deanxizian/MicroDuck-Replica/Software/README.md

# 软件

软件部分待补充，包括系统镜像、驱动、舵机标定、IMU 校准，以及相机、ToF 和音频配置。
