deanxizian/MicroDuck-Replica/Hardware/HUB/README.md

# kissqy HUB

采用 kissqy HUB 成品分线板，包含连接器和缓冲电容。供电从 Banana 接入 VIN／GND，舵机总线按实板标记连接。

Blender 使用 HUB V2 参考模型，安装在电池仓支座，两安装孔参考间距为 19 mm。实际版号、连接器及电容高度需与成品核对。

本目录仅提供装配说明，未收录 KiCad 或嘉立创制造文件。采购明细见 [BOM](../../BOM/README.md)。
