deanxizian/MicroDuck-Replica/Hardware/IMU-AMP2.0/README.md

# kissqy IMU AMP2.0

采用外购 IMU TO DXL 成品。此处保留 kissqy 2026-10-15 工程的 KiCad 10.99 导入版及制造参考。

| 资料 | 文件 |
| --- | --- |
| KiCad | [工程](KiCad/IMU-AMP2.0.kicad_pro) · [原理图](KiCad/IMU-AMP2.0.kicad_sch) · [PCB](KiCad/IMU-AMP2.0.kicad_pcb) |
| 嘉立创 | [Gerber](JLC/Gerber-reference.zip) · [原理图 PDF](JLC/schematic.pdf) · [BOM](JLC/BOM-reference.csv) · [坐标](JLC/positions-kicad-reference.csv) |
| 检查记录 | [Verification](Verification/) |

25 个器件、93 个焊盘网络已有导入一致性记录，PCB 附带 11 类元件模型。完整 ERC/DRC 和 SMT 审核未完成，CSV 保留导入图框及安装焊盘记录。

安装孔距 16.51×19.812 mm，使用四个约 2 mm 高隔离垫避开背面焊针；螺钉长度按实装选择。成品固件版本、烧录状态与本机校准需在安装时确认。

遵循 kissqy 个人非商业许可及第三方原许可，见 [来源说明](../../NOTICE.md)。
