deanxizian/MicroDuck-Replica/Hardware/Radxa-ZERO-3W/README.md

# Radxa ZERO 3W

| 方案 | 内存与存储 | 排针 |
| --- | --- | --- |
| 推荐配置 | 2GB RAM、无 eMMC，另配 32GB TF 卡 | 购买已焊排针版 |
| 本机配置 | 4GB RAM＋32GB eMMC，¥800 | 无排针，另购 2×20P 排针焊接 |

主控通过四根柱固定在脸板上，安装柱已下移 1.5 mm，柱高不变。摄像头使用独立安装柱，排线需匹配主控与相机两端的针数、触点面和引脚定义。

本目录仅提供选型与安装说明。采购明细见 [BOM](../../BOM/README.md)。
