deanxizian/MicroDuck-Replica/Peripherals/ToF/README.md

# VL53L5CX 安装

模块横装，焊盘排朝下，光轴朝前；感光中心与摄像头等高。安装孔距 20 mm，23 号打印孔距 19.8 mm；支撑高 3 mm，盲孔底厚 1.3 mm。

采用 SH1.0／4P／10 cm 双头线：一端接 HAT，另一端剪去插头，直接焊到 ToF 模块背面的焊盘。按两端接口定义核对电源、地、SCL 和 SDA，不按线色判断。规格与购买链接见 [BOM](../../BOM/README.md)。

焊好线后再固定模块，整理出线方向后合上头盖。ToF 距离阵列的分区方向需按模块旋转 180° 后的朝向校正；实物走线和测距仍需验证。
