deanxizian/MicroDuck-Replica/Hardware/Banana-NP-F550/JLC/Banana-PPTC-schematic.pdf

1 | 2 | 3 | 4 | 5 | 6
1 | 2 | 3 | 4 | 5 | 6

AB

C

D

AB

C

## D Date: 2026-11-03

Size: A4 | Rev: 0.5-PPTC
KiCad E.D.A. 10.0.7 | Id: 1/1

# Title: MicroDuck Banana - positive-side PPTC prototype

## File: banana_pptc.kicad_sch

## Sheet: /

## Based on jyg9 banana_pcb 0.2; CERN-OHL-P v2

1

1

2

2

J3 POWER_OUT 1

1

J1 BAT+

F1
7A hold / 12V 1

1

J2 BAT-

BATT_POS | VOUT_FUSED

BATT_NEG

F1 reference: Littelfuse 2920L700/12MR, 2920 package.

Ihold 7 A / Itrip 14 A at 20 C; Vmax 12 V. 7 A is NOT an instant cutoff. Check motor startup, warm hold current and fault heating on the actual robot. Board 39.19 x 6.79 x 1.6 mm; 1 oz copper each side. F1 on LEFT; J3 moved 8 mm RIGHT to the revised holder notch. J3.1 LEFT fused positive / J3.2 RIGHT direct battery negative. The PPTC limits current when hot; clear the fault and disconnect power to reset. Not a substitute for battery protection or individual servo protection. 3D fuse is a reference maximum-envelope model; actual substitute and cable fit unverified. Original outline/contact design: jyg9/microduck-community-kit, CERN-OHL-P v2. 2026-11-03: three direct 3 mm front tracks; no back tracks; no vias. MicroDuck NP-F550 Banana PCB + PPTC

0.5-PPTC / positive-side fuse / right wire exit / prototype

### J1 -> F1.1/F1.2 -> J3.1 -> HUB CN1.2 (VIN+) J2 -------------> J3.2 -> HUB CN1.1 (GND-)
