deanxizian/MicroDuck-Replica/Peripherals/Camera/Yahboom-IMX219-parameters.jpg

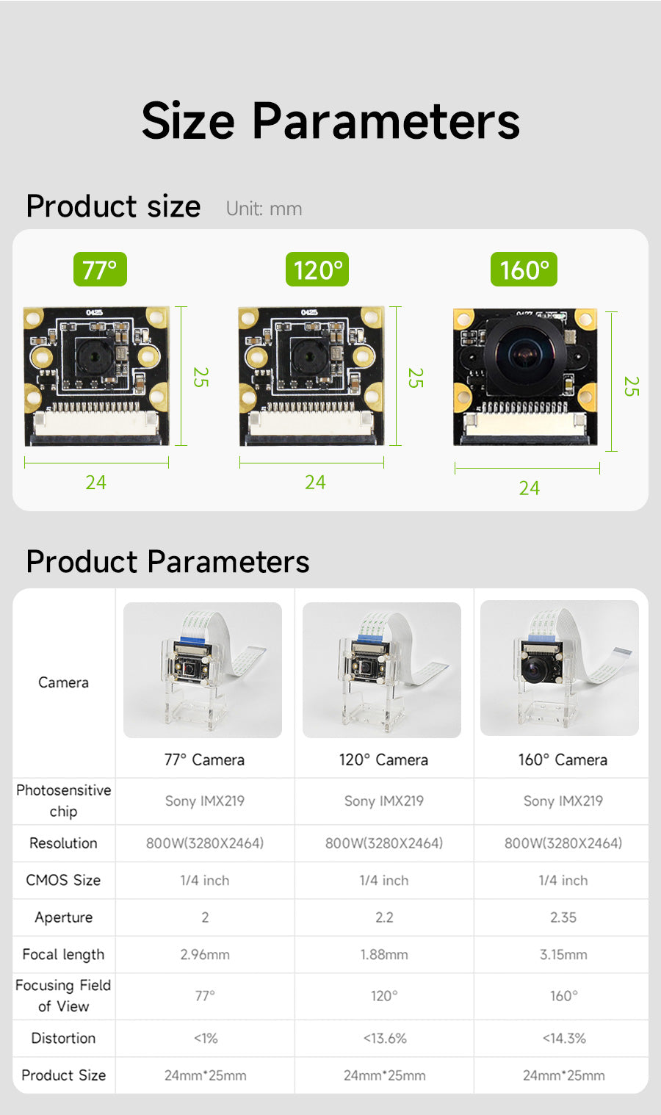
Peripherals/Camera/Yahboom-IMX219-parameters.jpg
