deanxizian/MicroDuck-Replica/Peripherals/Microphone/EM4015-rubber-dimensions.png

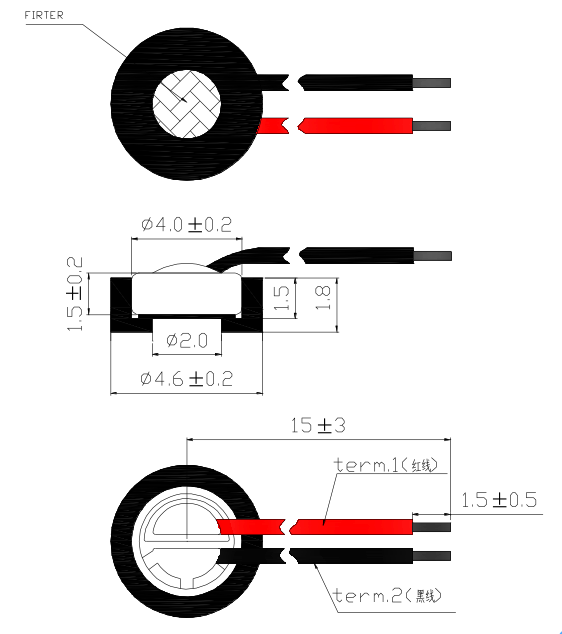
Peripherals/Microphone/EM4015-rubber-dimensions.png
