deanxizian/MicroDuck-Replica/Hardware/Banana-NP-F550/JLC/Banana-PPTC-SMT-BOM.csv

Designator | Quantity | Comment | Footprint | Manufacturer | Manufacturer Part Number | Notes
F1 | 1 | 7A hold / 12V PPTC - prototype selection | PPTC_Littelfuse_2920L | Littelfuse | 2920L700/12MR | User-requested substitute: 伯特 BSMD2920-700-12V; manufacturer datasheet and compatibility unverified.
