deanxizian/MicroDuck-Replica/Hardware/HAT-AMP2.0/JLC/BOM-reference.csv

Refs | Value | Footprint | Qty | DNP
? |  |  | 1
C1 | 1uF / left AC coupling | ProPrj_HAT-easyedapro:C0603 | 1
C2 | 1uF / right AC coupling | ProPrj_HAT-easyedapro:C0603 | 1
C3 | 1uF / VREF | ProPrj_HAT-easyedapro:C0603 | 1
C4 | 1uF | ProPrj_HAT-easyedapro:C0603 | 1
C5 | 10uF | ProPrj_HAT-easyedapro:C0603 | 1
C6 | 1uF | ProPrj_HAT-easyedapro:C0603 | 1
C7 | 10uF | ProPrj_HAT-easyedapro:C0603 | 1
C8 | 220pF | ProPrj_HAT-easyedapro:C0603 | 1
C9 | 220pF | ProPrj_HAT-easyedapro:C0603 | 1
C10 | 1uF / onboard MIC coupling | ProPrj_HAT-easyedapro:C0603 | 1
C11 | 100nF / onboard MIC | ProPrj_HAT-easyedapro:C0603 | 1
C12 | 10uF / 1V8 | ProPrj_HAT-easyedapro:C0603 | 1
C13 | 10uF / 3V3 | ProPrj_HAT-easyedapro:C0603 | 1
C14 | 100nF / oscillator | ProPrj_HAT-easyedapro:C0603 | 1
C15 | 10uF | ProPrj_HAT-easyedapro:C1206 | 1
C16 | 100nF / U5 | ProPrj_HAT-easyedapro:C0603 | 1
C17 | 100nF / U6 | ProPrj_HAT-easyedapro:C0603 | 1
C18 | 100nF / U7 | ProPrj_HAT-easyedapro:C0603 | 1
C20 | 100nF 50V / bootstrap | ProPrj_HAT-easyedapro:C0603 | 1
C21 | 22uF 10V X5R | ProPrj_HAT-easyedapro:C0603 | 1
C22 | 22uF 10V X5R | ProPrj_HAT-easyedapro:C0603 | 1
C26 | 100nF / 1V8 | ProPrj_HAT-easyedapro:C0603 | 1
C27 | 1uF | ProPrj_HAT-easyedapro:C0603 | 1
C28 | 100nF | ProPrj_HAT-easyedapro:C0603 | 1
C29 | 1uF | ProPrj_HAT-easyedapro:C0603 | 1
C30 | 100nF | ProPrj_HAT-easyedapro:C0603 | 1
C31 | 1uF | ProPrj_HAT-easyedapro:C0603 | 1
C32 | 100nF | ProPrj_HAT-easyedapro:C0603 | 1
C33 | 1uF | ProPrj_HAT-easyedapro:C0603 | 1
C34 | 10nF | ProPrj_HAT-easyedapro:C0603 | 1
C35 | 1uF | ProPrj_HAT-easyedapro:C0603 | 1
C36 | 100nF | ProPrj_HAT-easyedapro:C0603 | 1
C37 | 10uF / 3V3 | ProPrj_HAT-easyedapro:C0603 | 1
C38 | 100nF / codec reset | ProPrj_HAT-easyedapro:C0603 | 1
C39 | 100nF 50V | ProPrj_HAT-easyedapro:C0603 | 1
C40 | 1uF / MIC R coupling | ProPrj_HAT-easyedapro:C0603 | 1
C41 | 1uF / MIC L coupling | ProPrj_HAT-easyedapro:C0603 | 1
C42 | 1uF / MIC supply | ProPrj_HAT-easyedapro:C0603 | 1
C43 | 1uF / MIC supply | ProPrj_HAT-easyedapro:C0603 | 1
D1 | BAT54SW / diode 1 used | ProPrj_HAT-easyedapro:SOT-323_L2.0-W1.3-P1.30-LS2.1-BR | 1
D4 | 5V1 / bus clamp | ProPrj_HAT-easyedapro:SOD-323_L1.8-W1.3-LS2.5-RD | 1
D5 | GREEN / RX activity | ProPrj_HAT-easyedapro:LED0603-RD | 1
FB1 | 600R@100MHz 1.3A | ProPrj_HAT-easyedapro:L0603 | 1
FB2 | 120R@100MHz 2A | ProPrj_HAT-easyedapro:L0603 | 1
FB3 | 120R@100MHz 2A | ProPrj_HAT-easyedapro:L0603 | 1
J1 | SPK R / A1251 1.25mm 2P | ProPrj_HAT-easyedapro:CONN-TH_2P-P1.25_A1251WV-2P | 1
J2 | MIC L / A1251 1.25mm 2P | ProPrj_HAT-easyedapro:CONN-TH_2P-P1.25_A1251WV-2P | 1
J4 | FH-00339 stock pins / Zero pair-map / bottom | ProPrj_HAT-easyedapro:HDR-SMD_40P-P2.54-V-F-R2-C20-S6.6_FH-00339 | 1
J5 | ToF / Qwiic / pad 0 GND | ProPrj_HAT-easyedapro:CONN-SMD_BM04B-SRSS-TB | 1
J9 | MIC R / A1251 1.25mm 2P | ProPrj_HAT-easyedapro:CONN-TH_2P-P1.25_A1251WV-2P | 1
J13 | DXL / A2007 2.0mm 3P | ProPrj_HAT-easyedapro:CONN-TH_A2007WV-3P | 1
J14 | DXL / A2007 2.0mm 3P | ProPrj_HAT-easyedapro:CONN-TH_A2007WV-3P | 1
L4 | 6.8uH / 3A / Isat 4.3A | ProPrj_HAT-easyedapro:IND-SMD_L6.0-W6.0_SWPA6045S | 1
MK1 | Onboard analog MEMS MIC | ProPrj_HAT-easyedapro:MIC-SMD_4P-L2.8-W1.9-P1.84-TL | 1
Q1 | MMBT3906 / direction | ProPrj_HAT-easyedapro:SOT-23-3_L2.9-W1.4-P1.91-LS2.6-BR | 1
Q2 | SI2312 / ideal diode MOS | ProPrj_HAT-easyedapro:SOT-23_L2.9-W1.3-P1.90-LS2.4-BR | 1
R1 | 10k / INL | ProPrj_HAT-easyedapro:R0603 | 1
R2 | 10k / INR | ProPrj_HAT-easyedapro:R0603 | 1
R3 | 0R / SHDN high | ProPrj_HAT-easyedapro:R0603 | 1
R4 | 0R / MUTE high | ProPrj_HAT-easyedapro:R0603 | 1
R5 | 0R / MODE high | ProPrj_HAT-easyedapro:R0603 | 1
R6 | 10k / codec reset | ProPrj_HAT-easyedapro:R0603 | 1
R7 | 0R / MIC2L to GND | ProPrj_HAT-easyedapro:R0603 | 1
R8 | 100R | ProPrj_HAT-easyedapro:R0603 | 1
R12 | 10k / SDA pull-up | ProPrj_HAT-easyedapro:R0603 | 1
R13 | 10k / SCL pull-up | ProPrj_HAT-easyedapro:R0603 | 1
R22 | 10k / MIC L bias | ProPrj_HAT-easyedapro:R0603 | 1
R23 | 10k / MIC R bias | ProPrj_HAT-easyedapro:R0603 | 1
R26 | 10k / UART TX pull-up | ProPrj_HAT-easyedapro:R0603 | 1
R27 | 10k / direction base | ProPrj_HAT-easyedapro:R0603 | 1
R28 | 20k / direction pull-down | ProPrj_HAT-easyedapro:R0603 | 1
R29 | 10k / RX gate enable | ProPrj_HAT-easyedapro:R0603 | 1
R31 | 10k / RX pull-up | ProPrj_HAT-easyedapro:R0603 | 1
R32 | 10k / data pull-up | ProPrj_HAT-easyedapro:R0603 | 1
R33 | 0Ω | ProPrj_HAT-easyedapro:R0603 | 1
R34 | 1k / LED current | ProPrj_HAT-easyedapro:R0603 | 1
TH1 | 0Ω | ProPrj_HAT-easyedapro:F0603 | 1
U1 | PAM8406D | ProPrj_HAT-easyedapro:SOIC-16_L9.9-W3.9-P1.27-LS6.0-BL | 1
U2 | TLV320AIC3104IRHBR | ProPrj_HAT-easyedapro:HVQFN-32_L5.0-W5.0-P0.50-TL-EP | 1
U3 | XC6206P182 / 1V8 | ProPrj_HAT-easyedapro:SOT-23-3_L3.0-W1.7-P0.95-LS2.9-BR | 1
U5 | 74LVC1G08 / RX gate | ProPrj_HAT-easyedapro:SOT-23-5_L3.0-W1.7-P0.95-LS2.8-BR | 1
U6 | SN74LVC1G125DBVR | ProPrj_HAT-easyedapro:SOT-23-5_L2.9-W1.6-P0.95-LS2.8-BL | 1
U7 | SN74LVC1G126 / TX | ProPrj_HAT-easyedapro:SOT-23-5_L3.0-W1.7-P0.95-LS2.8-BR | 1
U9 | AP63205 / 5V buck | ProPrj_HAT-easyedapro:TSOT-23-6_L2.9-W1.6-P0.95-LS2.8-BL | 1
U10 | LM5050-1 | ProPrj_HAT-easyedapro:TSOT-23-6_L2.9-W1.6-P0.95-LS2.8-BL | 1
Y1 | 12MHz | ProPrj_HAT-easyedapro:OSC-SMD_4P-L2.5-W2.0-BL | 1
