deanxizian/MicroDuck-Replica/Hardware/HAT-D1-HD1910/JLC/MicroDuck-HAT-D1-HD1910-BOM.csv

Comment | Designator | Footprint | Quantity | 嘉立创元件编号 | Manufacturer | MPN
1uF | C1,C2,C3,C4,C6,C10,C27,C29,C31,C33,C35,C40,C41,C42,C43 | 0402 | 15 | C52923
10uF | C5,C7,C12,C13,C37 | 0603 | 5 | C1691
220nF | C8,C9 | 0402 | 2 | C71693
100nF | C11,C14,C15,C16,C17,C18,C26,C28,C30,C32,C36,C38 | 0402 | 12 | C307331
10uF 63V | C19 | SMD D6.3xH7.7mm | 1 |  | Kemet | EDK106M100A9HAA
100nF 50V | C20 | 0402 | 1 | C307331 | Eurocircuit | GPC0402104
22uF 6.3V | C21,C22 | 0603 | 2 | C84419 | Murata | GRM188R61A226ME15D
100nF 6.3V | C23,C24,C39 | 0402 | 3 | C1525
10nF | C34,C44 | 0402 | 2 | C15195
10uF 35V | C45 | 0805 | 1 | C33546007
BAT54SW,115 | D1 | SOT-323 | 1 | C78606 | Nexperia | BAT54SW,115
3.3V Zener Diode | D2 | D_SOD-123 | 1 | C19077392
BZX384C5V1-E3-08 5.1V | D4 | D_SOD-323 | 1 | C151348 | Vishay | BZX384C5V1-E3-08
1.3A 600R@100MHz | FB1 | 0402 | 1 | C76884 | Murata | BLM15AG601SN1D
2A - 120R@100MHz | FB2,FB3 | 0402 | 2 | C88970
A1251WV-2P | J1,J2,J9 | TH 1x02 P1.25mm | 3 | C225090 | CJT | A1251WV-2P
Dynamixel-4 | J3,J11 | TH 1x04 P2.50mm | 2 | C160258
Female Header 2x20 SMD | J4 | SMD 2x20 P2.54mm | 1 | C2685112
JST SH | J5,J6,J7,J8 | SMD 1x04 P1.00mm | 4 | C160390
A2007WV-3P | J13,J14 | TH 1x03 P2.00mm | 2 | C225336 | CJT | A2007WV-3P
6.8uH 2A | L4 | L_Bourns_SRN6045TA | 1 | C57254 | Bourns | SRN6045TA-6R8M
LMA2718T421-OA5-2 | MK1 | MIC-SMD_4P-L2.8-W1.9-P1.84-TL | 1 | C7587901 | LinkMems | LMA2718T421-OA5-2
MMBT3906 | Q1 | SOT-23 | 1 | C727128
N-Channel 5A | Q2 | TSOT-23 | 1 | C22469448
10kOhm | R1,R2,R6,R12,R13,R20,R21,R24,R26,R27,R29,R31,R32,R34,R35,R38,R39 | 0402 | 17 | C25744
0Ohm | R3,R4,R5,R7,R9,R14,R15,R18,R19,R25,R30,R40 | 0402 | 12 | C17168
100Ohm | R8 | 0402 | 1 | C2906860
4.7kOhm | R22,R23 | 0402 | 2 | C105871
20kOhm | R28 | 0402 | 1 | C25765
150Ohm | R33 | 0402 | 1 | C2909321
1kOhm | R42 | 0402 | 1 | C105637
100R thermistor | TH1 | 0603 | 1 | C913703 | Murata | PRG18BB101MB1RB
Test point loop D2.50mm drill 1.0mm low profile | TP2,TP3,TP4 | TH TestPoint D2.50mm Drill1.0mm | 3
PAM8406D | U1 | SOIC-16 3.9x9.9mm P1.27mm | 1 | C86270
TLV320AIC3104IRHBR | U2 | VQFN-32-1EP_5x5mm_P0.5mm_EP3.5x3.5mm | 1 | C181753
XC6206P182MR | U3 | SOT-23-3 | 1 | C347373
74LVC1G08 | U5 | SOT-23-5 | 1 | C7666
SN74LVC1G125DBV | U6 | SOT-23-5 | 1 | C23654 |  | SN74LVC1G125DBVT
SN74LVC1G126DBVR | U7 | SOT-23-5 | 1 | C7834 | TI | SN74LVC1G126DBVR
GM3088ENA | U8 | DFN-8-1EP_3x3mm_P0.65mm_EP1.2x2.15mm | 1 | C49423279 | Gatemode | GM3088ENA
AP63205 | U9 | TSOT-23-6 | 1 | C2071056 | Diodes Inc. | AP63205WU
LM5050-1 | U10 | TSOT-23-6 | 1 | C473393
LSM6DSV16XTR | U12 | LGA-14_3x2.5mm_P0.5mm_LayoutBorder3x4y | 1 | C5267406
OT3EL89CJI-111YLC-12M 12MHz | Y1 | Oscillator_SMD_Abracon_ASDMB-4Pin_2.5x2.0mm | 1 | C7425459 | YXC Crystal Oscillators | OT3EL89CJI-111YLC-12M
