deanxizian/MicroDuck-Replica/Hardware/IMU-AMP2.0/JLC/BOM-reference.csv

Refs | Value | Footprint | Qty | DNP
? |  |  | 1
C1 | 4.7uF 25V | ProPrj_imu-easyedapro:C0805 | 1
C2 | 100nF 50V | ProPrj_imu-easyedapro:C0603 | 1
C3 | 4.7uF 25V | ProPrj_imu-easyedapro:C0805 | 1
C4 | 100nF 50V | ProPrj_imu-easyedapro:C0603 | 1
C5 | 100nF / MCU | ProPrj_imu-easyedapro:C0603 | 1
C6 | 1uF / MCU | ProPrj_imu-easyedapro:C0603 | 1
C7 | 100nF / VDD_IO | ProPrj_imu-easyedapro:C0603 | 1
C8 | 100nF / VDD | ProPrj_imu-easyedapro:C0603 | 1
C9 | 1uF / IMU local | ProPrj_imu-easyedapro:C0603 | 1
C10 | 100nF / buffer | ProPrj_imu-easyedapro:C0603 | 1
D1 | PESD5V0S1BA / 5V bidirectional | ProPrj_imu-easyedapro:SOD-323_L1.7-W1.3-LS2.7-BI | 1
D2 | DEBUG LED | ProPrj_imu-easyedapro:LED0603-RD | 1
J1 | DXL BUS / CJT A2007WV-3P / AMP 2.0 | ProPrj_imu-easyedapro:CONN-TH_A2007WV-3P | 1
J2 | SWD 1x5 | ProPrj_imu-easyedapro:HDR-TH_5P-P2.54-V-M | 1
R1 | 0R / DXL_VDD link | ProPrj_imu-easyedapro:R0603 | 1
R2 | 10k / NRST pull-up | ProPrj_imu-easyedapro:R0603 | 1
R3 | 100k / BOOT0 pull-down | ProPrj_imu-easyedapro:R0603 | 1
R4 | 10k / IMU CS pull-up | ProPrj_imu-easyedapro:R0603 | 1
R5 | 10k / TX disable pull-up | ProPrj_imu-easyedapro:R0603 | 1
R6 | 33R / DXL TX series | ProPrj_imu-easyedapro:R0603 | 1
R7 | 1k / debug LED | ProPrj_imu-easyedapro:R0603 | 1
U1 | STM32G031F8P6 | ProPrj_imu-easyedapro:TSSOP-20_L6.5-W4.4-P0.65-LS6.4-BL | 1
U2 | LSM6DSV16XTR | ProPrj_imu-easyedapro:LGA-14_L3.0-W2.5-P0.50-BR | 1
U3 | TLV70433DBVR | ProPrj_imu-easyedapro:SOT-23-5_L3.0-W1.7-P0.95-LS2.8-BR | 1
U4 | SN74LVC2G125DCUR | ProPrj_imu-easyedapro:VSON8_L2.0-W2.3-P0.50-LS3.1-BL | 1
