deanxizian/MicroDuck-Replica/Hardware/Banana-NP-F550/KiCad/models/PPTC_2920L_max_envelope.step

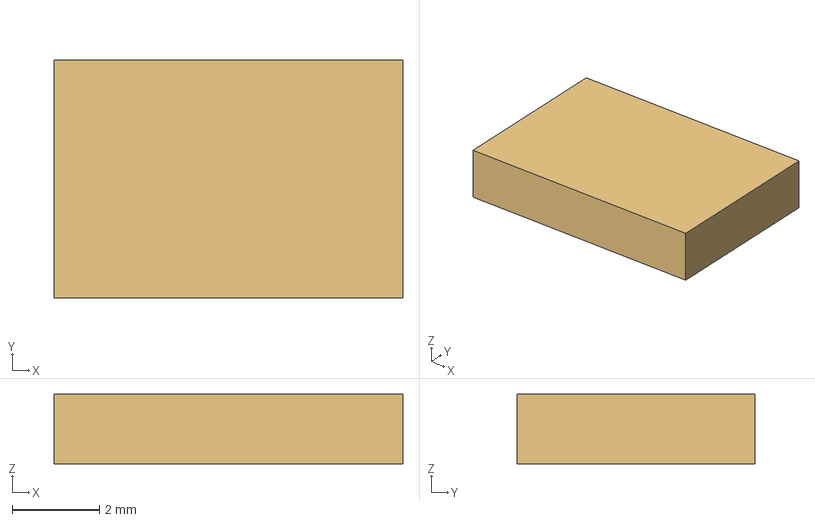
[picture p6: CAD file, 2026-11-04]
Hardware/Banana-NP-F550/KiCad/models/PPTC_2920L_max_envelope.step
7.98 x 5.44 x 1.60 mm
