deanxizian/MicroDuck-Replica/Hardware/HAT-D1-HD1910/KiCad/models/TDFN-8_L3.0-W2.0-H0.8-P0.50.step

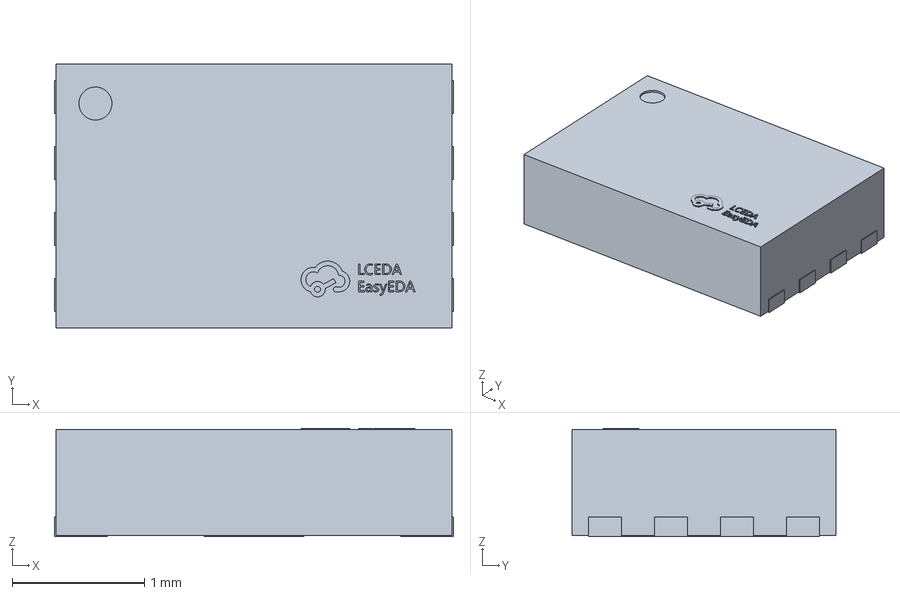
[picture p7: CAD file, 2026-11-04]
Hardware/HAT-D1-HD1910/KiCad/models/TDFN-8_L3.0-W2.0-H0.8-P0.50.step
3.02 x 2.00 x 0.82 mm
