deanxizian/MicroDuck-Replica/Hardware/IMU-AMP2.0/KiCad/models/LED0603-RD.step

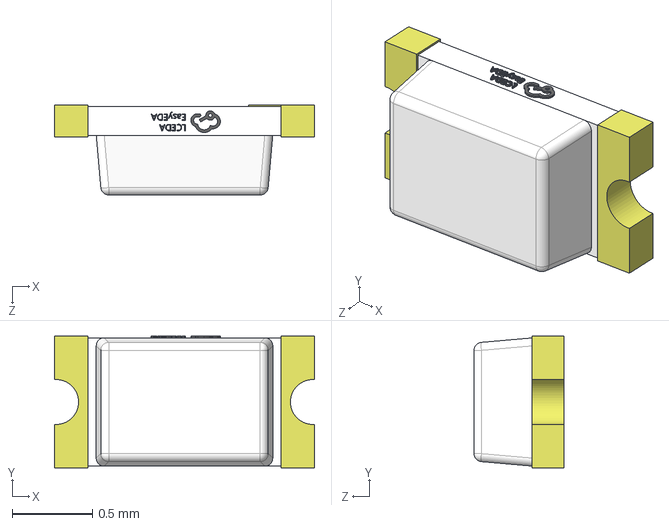
[picture p8: CAD file, 2026-11-04]
Hardware/IMU-AMP2.0/KiCad/models/LED0603-RD.step
1.62 x 0.82 x 0.56 mm
