deanxizian/MicroDuck-Replica/Structure/Print/STEP/01_9000HE_白色_8件/04_右脚掌_9000HE_白色.step

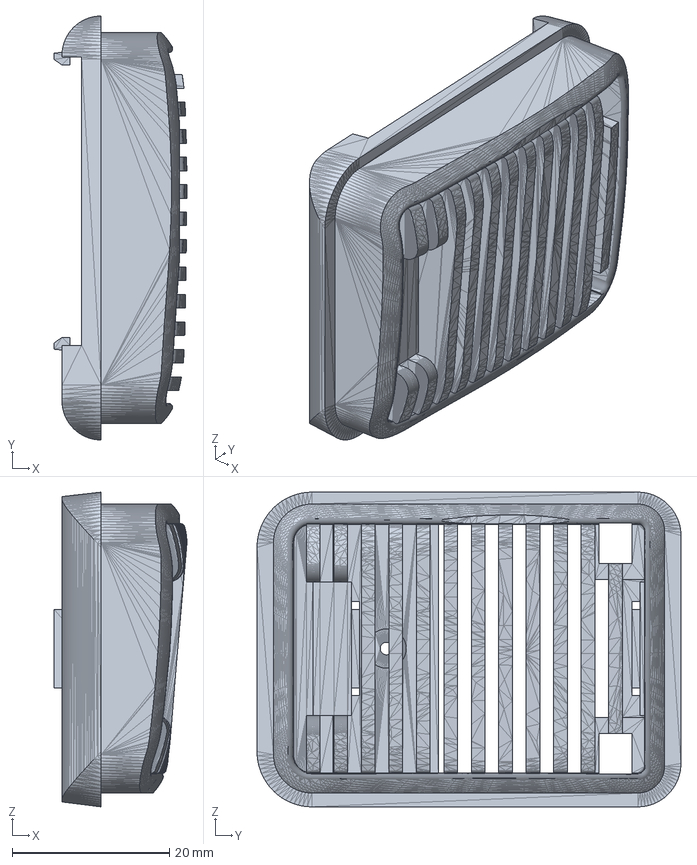
[picture p9: CAD file, 2026-11-04]
Structure/Print/STEP/01_9000HE_白色_8件/04_右脚掌_9000HE_白色.step
16.9 x 54.0 x 40.1 mm
