deanxizian/MicroDuck-Replica/Structure/Print/STEP/02_JLCBlack_黑色_3件/23_脸板_相机柱6.3_ToF横装等高_JLCBlack_黑色.step

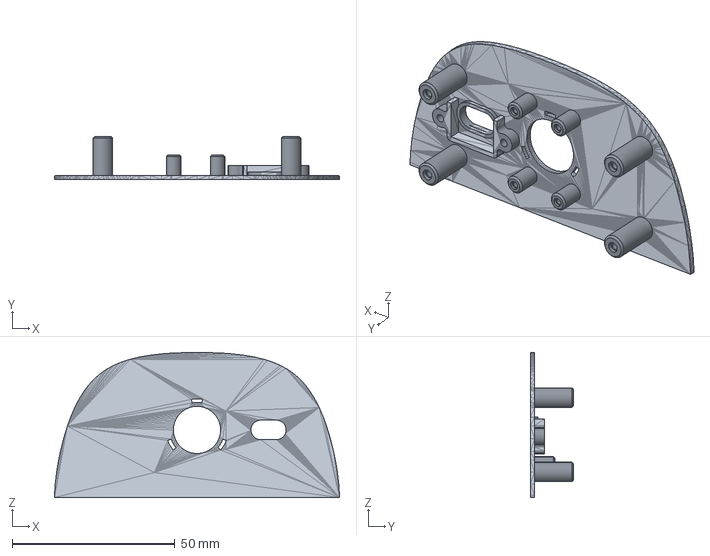
[picture p10: CAD file, 2026-11-05]
Structure/Print/STEP/02_JLCBlack_黑色_3件/23_脸板_相机柱6.3_ToF横装等高_JLCBlack_黑色.step
87.7 x 13.3 x 44.6 mm
