deanxizian/MicroDuck-Replica/Structure/Print/STEP/03_Grey_灰色_16件/16_右胯旋转_Grey_灰色.step

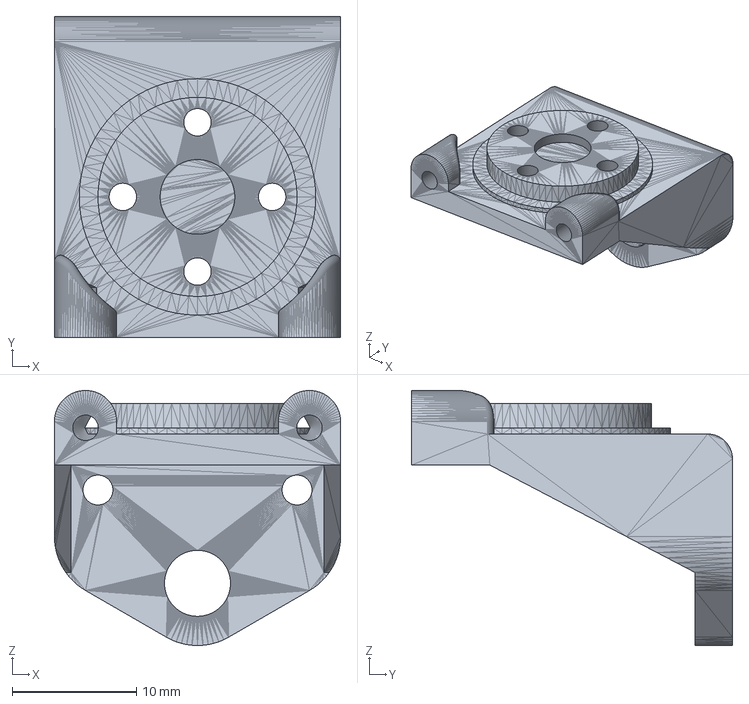
[picture p11: CAD file, 2026-11-04]
Structure/Print/STEP/03_Grey_灰色_16件/16_右胯旋转_Grey_灰色.step
23.0 x 25.8 x 20.5 mm
