deanxizian/MicroDuck-Replica/Structure/Print/STEP/04_TPU95A_黑色_2件/02_右脚底_TPU95A_黑色.step

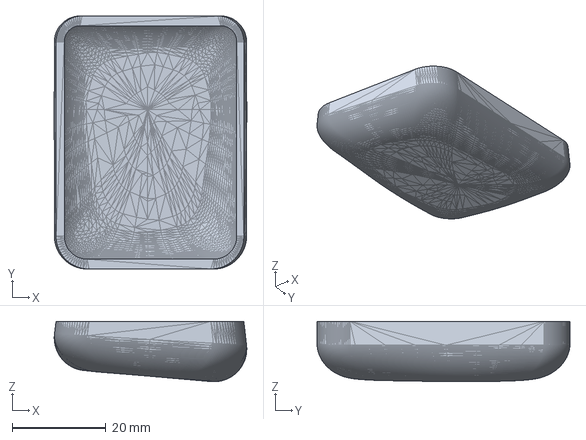
[picture p12: CAD file, 2026-11-04]
Structure/Print/STEP/04_TPU95A_黑色_2件/02_右脚底_TPU95A_黑色.step
41.1 x 54.0 x 12.9 mm
