deanxizian/MicroDuck-Replica/Hardware/Banana-NP-F550/KiCad/models/Banana_U6068_size_reference.step

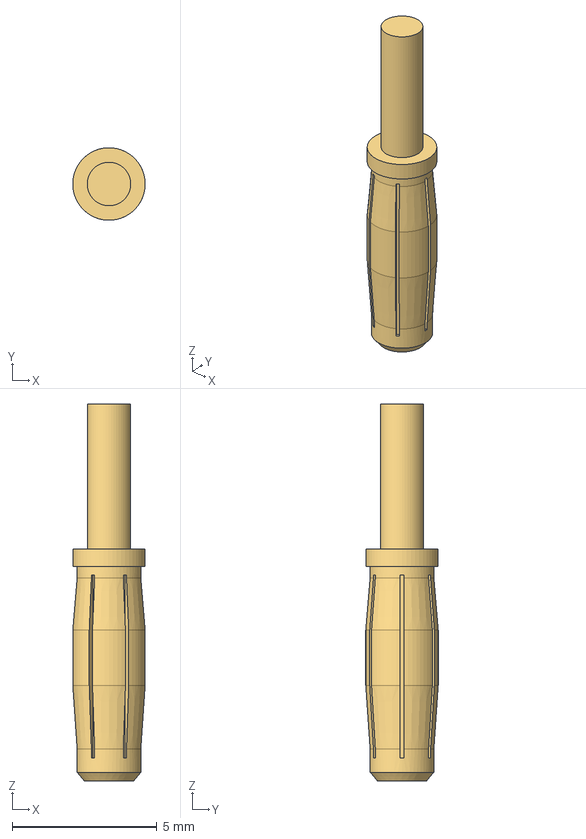
[picture p13: CAD file, 2026-11-04]
Hardware/Banana-NP-F550/KiCad/models/Banana_U6068_size_reference.step
2.50 x 2.50 x 13.0 mm
