deanxizian/MicroDuck-Replica/Hardware/HAT-D1-HD1910/KiCad/models/HDR-SMD_40P-P2.54-V-F-R2-C20-S6.6_FH-00339.step

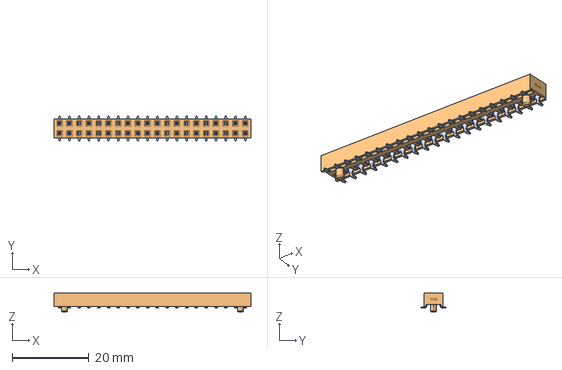
[picture p14: CAD file, 2026-11-04]
Hardware/HAT-D1-HD1910/KiCad/models/HDR-SMD_40P-P2.54-V-F-R2-C20-S6.6_FH-00339.step
51.2 x 6.60 x 4.90 mm
