deanxizian/MicroDuck-Replica/Hardware/IMU-AMP2.0/KiCad/models/C0603_L1.6-W0.8-H0.8.step

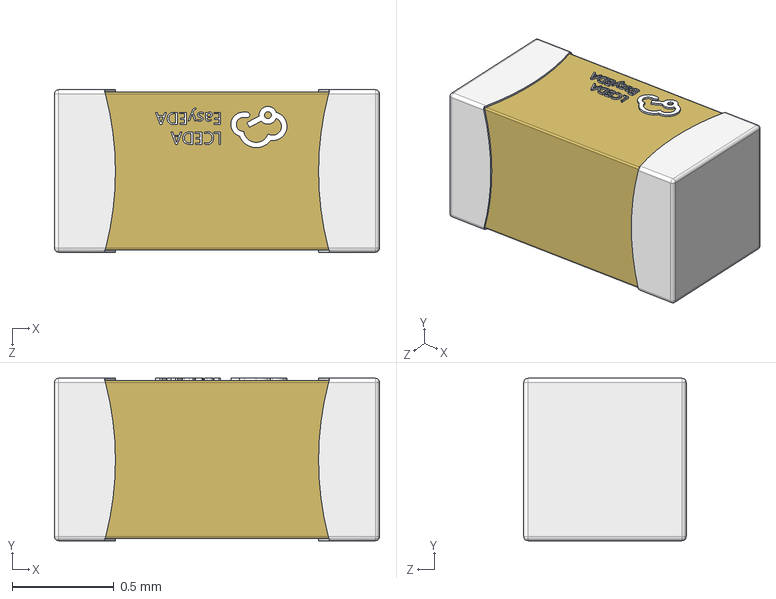
[picture p15: CAD file, 2026-11-04]
Hardware/IMU-AMP2.0/KiCad/models/C0603_L1.6-W0.8-H0.8.step
1.60 x 0.8 x 0.8 mm
