deanxizian/MicroDuck-Replica/Structure/Print/STEP/02_JLCBlack_黑色_3件/27_眼睛_厚6mm_JLCBlack_黑色.step

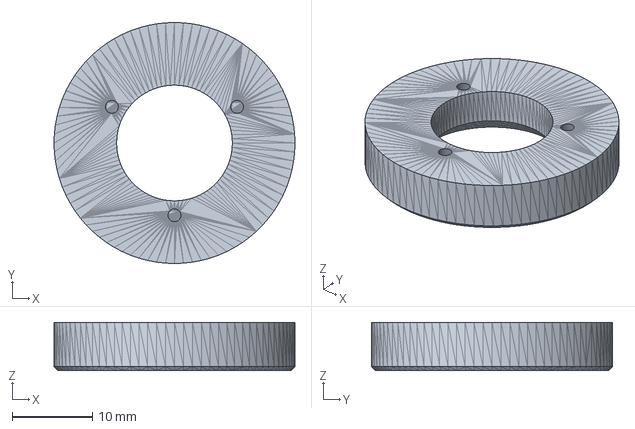
[picture p16: CAD file, 2026-11-05]
Structure/Print/STEP/02_JLCBlack_黑色_3件/27_眼睛_厚6mm_JLCBlack_黑色.step
30.0 x 30.0 x 6.00 mm
