deanxizian/MicroDuck-Replica/Structure/Print/STEP/03_Grey_灰色_16件/19_颈部固定左_Grey_灰色.step

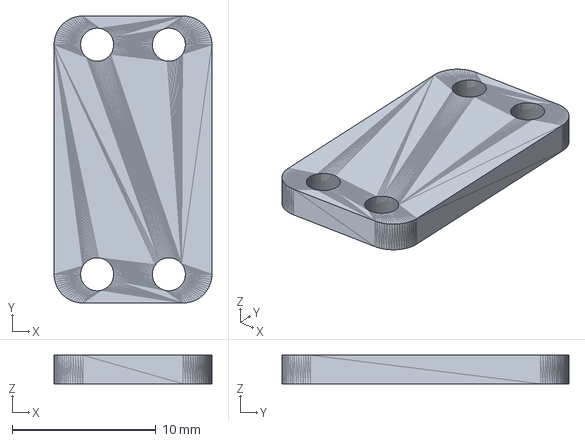
[picture p17: CAD file, 2026-11-04]
Structure/Print/STEP/03_Grey_灰色_16件/19_颈部固定左_Grey_灰色.step
11.0 x 20.0 x 2.00 mm
