deanxizian/MicroDuck-Replica/Hardware/Banana-NP-F550/KiCad/models/PPTC_2920_reference.step

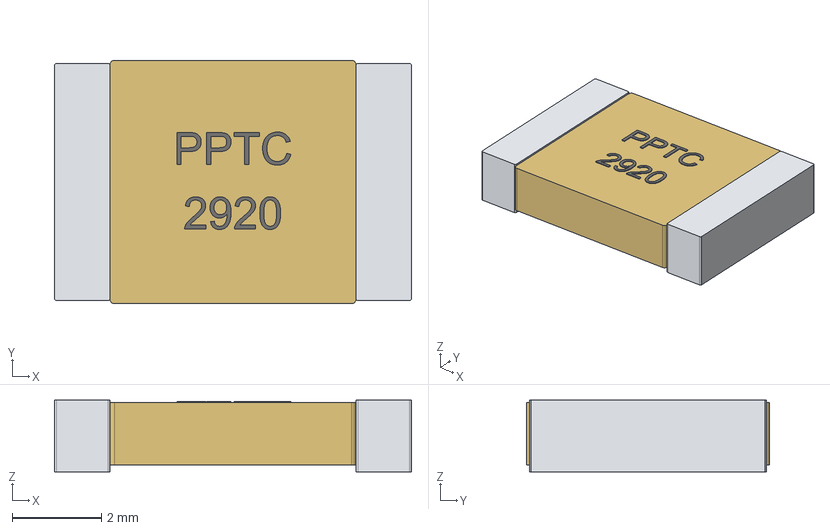
[picture p18: CAD file, 2026-11-04]
Hardware/Banana-NP-F550/KiCad/models/PPTC_2920_reference.step
7.98 x 5.44 x 1.60 mm
PPTC_body_reference
Termination_1
Termination_2
Generic_mark_PPTC
Generic_mark_2920
