deanxizian/MicroDuck-Replica/Hardware/HAT-D1-HD1910/KiCad/models/CONN-TH_MX1.25-LI-2P.step

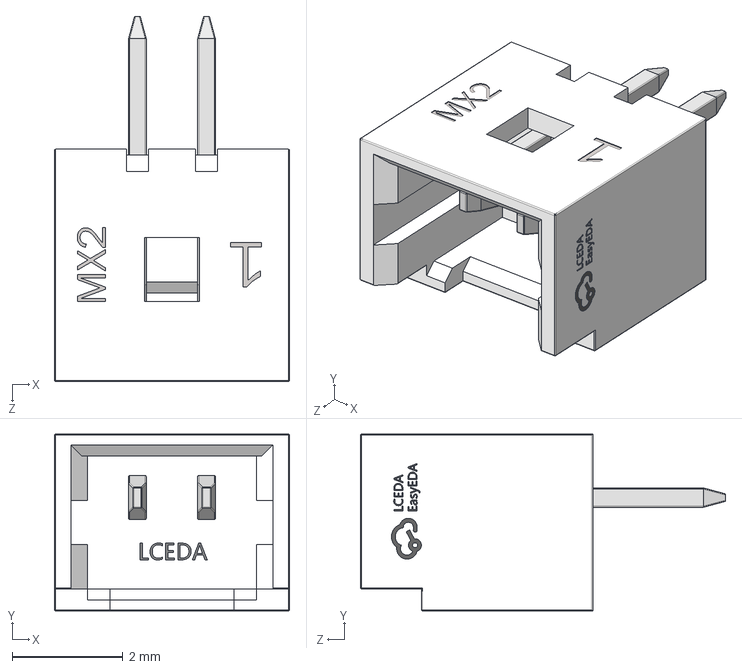
[picture p19: CAD file, 2026-11-04]
Hardware/HAT-D1-HD1910/KiCad/models/CONN-TH_MX1.25-LI-2P.step
4.25 x 3.20 x 6.60 mm
