deanxizian/MicroDuck-Replica/Hardware/IMU-AMP2.0/KiCad/models/R0603.step

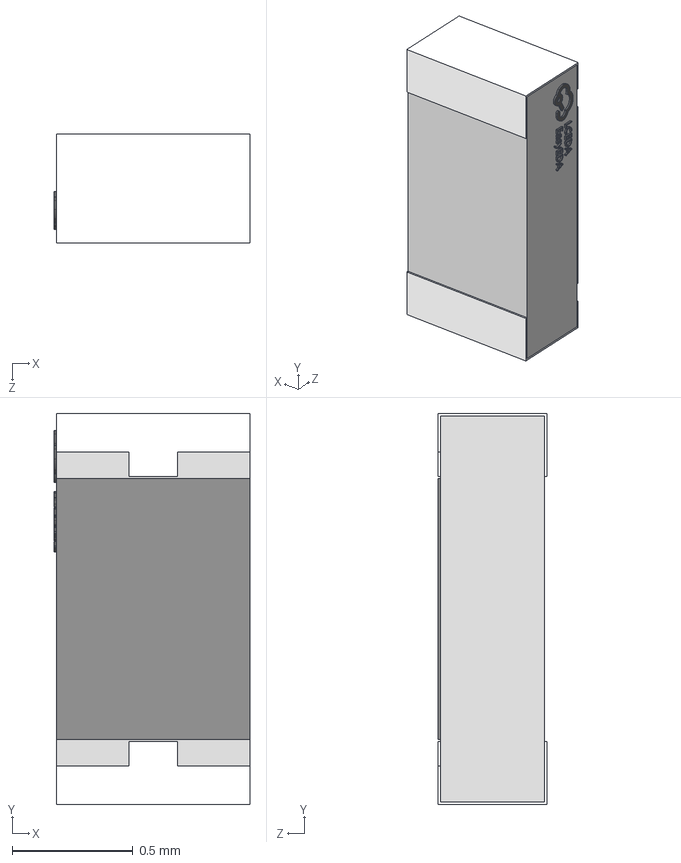
[picture p20: CAD file, 2026-11-04]
Hardware/IMU-AMP2.0/KiCad/models/R0603.step
0.81 x 1.62 x 0.45 mm
