deanxizian/MicroDuck-Replica/Structure/Print/STEP/01_9000HE_白色_8件/25_头盖_双麦_短扬声器粘贴面_9000HE_白色_v3.1.step

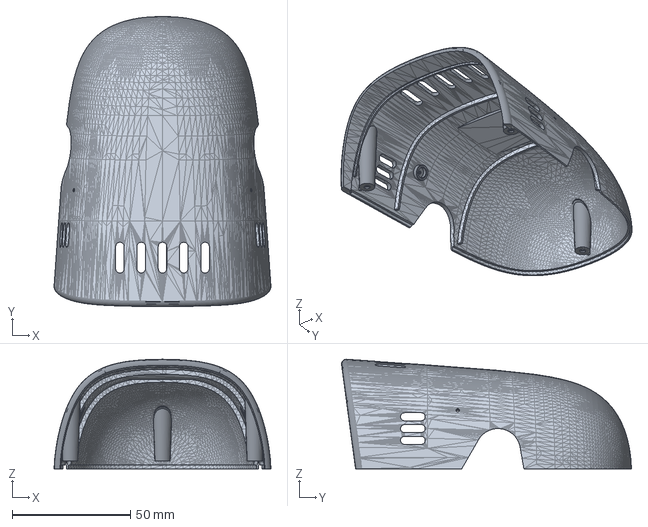
[picture p21: CAD file, 2026-11-04]
Structure/Print/STEP/01_9000HE_白色_8件/25_头盖_双麦_短扬声器粘贴面_9000HE_白色_v3.1.step
91.8 x 122.7 x 46.3 mm
