deanxizian/MicroDuck-Replica/Structure/Print/STEP/02_JLCBlack_黑色_3件/31_电池仓_右侧出线缺口_JLCBlack_黑色_v3.1.step

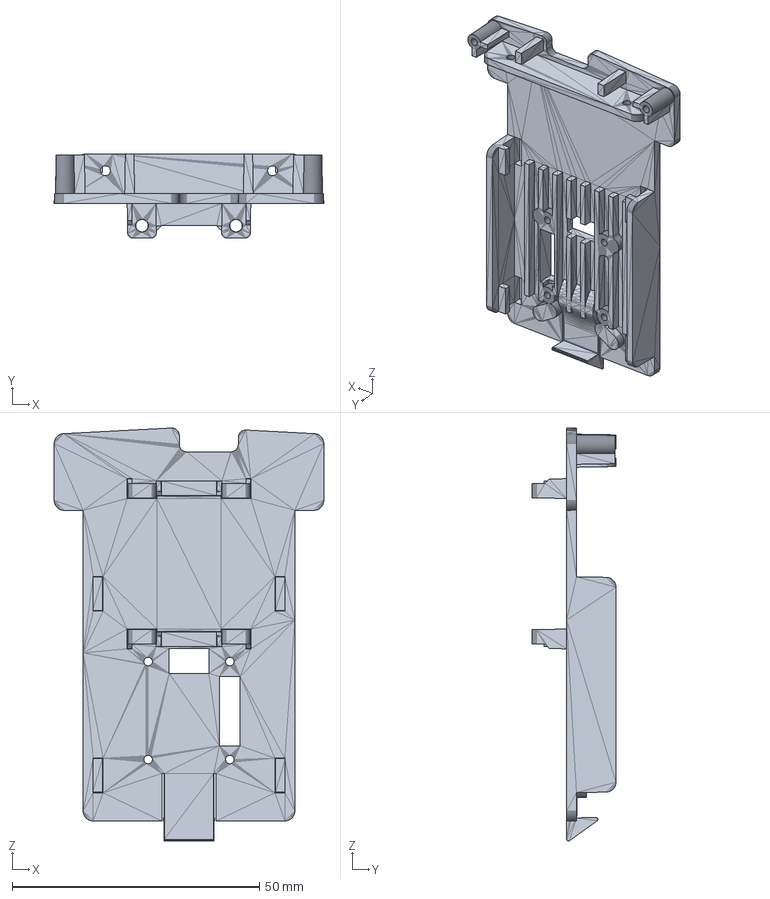
[picture p22: CAD file, 2026-11-04]
Structure/Print/STEP/02_JLCBlack_黑色_3件/31_电池仓_右侧出线缺口_JLCBlack_黑色_v3.1.step
54.5 x 17.0 x 83.5 mm
