deanxizian/MicroDuck-Replica/Hardware/HAT-D1-HD1910/KiCad/models/CONN-TH_A2007WV-3P.step

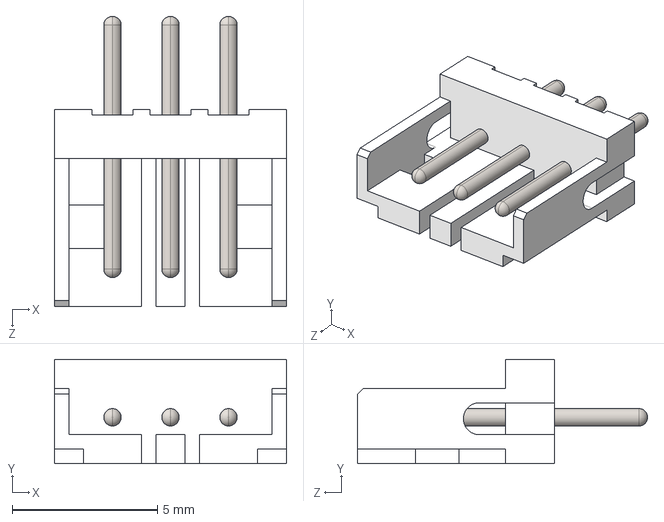
[picture p23: CAD file, 2026-11-04]
Hardware/HAT-D1-HD1910/KiCad/models/CONN-TH_A2007WV-3P.step
8.00 x 3.60 x 10.0 mm
