deanxizian/MicroDuck-Replica/Hardware/IMU-AMP2.0/KiCad/models/C0805_L2.0-W1.3-H1.3.step

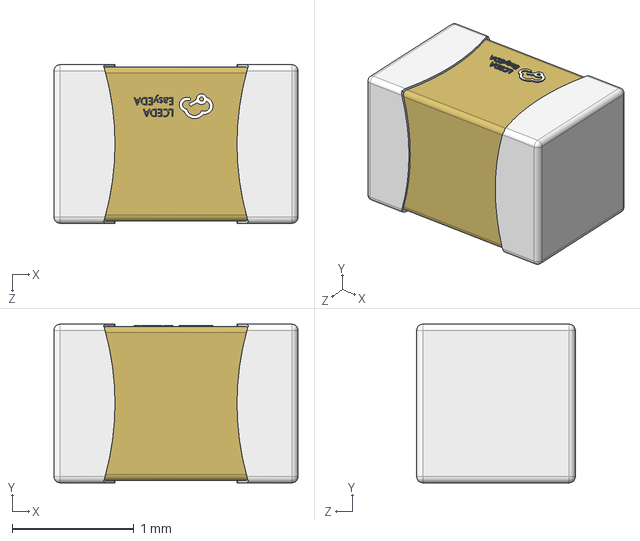
[picture p24: CAD file, 2026-11-04]
Hardware/IMU-AMP2.0/KiCad/models/C0805_L2.0-W1.3-H1.3.step
2.00 x 1.30 x 1.30 mm
