deanxizian/MicroDuck-Replica/Structure/Print/STEP/01_9000HE_白色_8件/29_右壳_连续孔口_9000HE_白色_v3.1.step

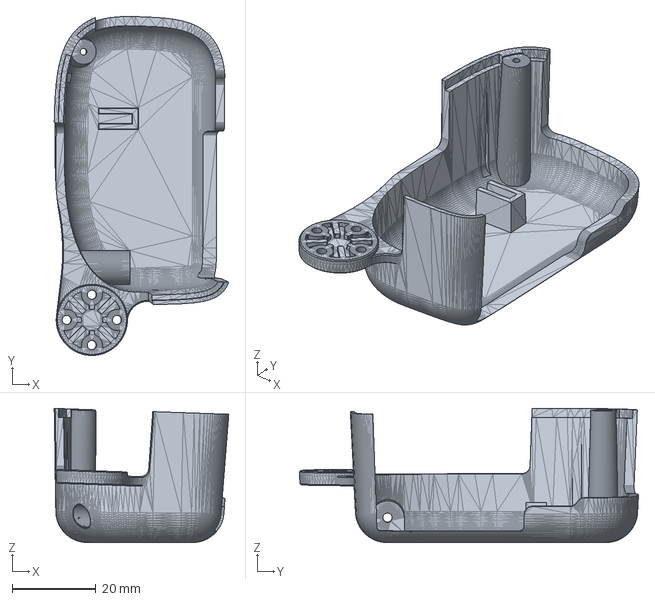
[picture p25: CAD file, 2026-11-04]
Structure/Print/STEP/01_9000HE_白色_8件/29_右壳_连续孔口_9000HE_白色_v3.1.step
41.7 x 80.9 x 32.0 mm
