deanxizian/MicroDuck-Replica/Structure/Print/STEP/03_Grey_灰色_16件/13_左胯侧摆_连续实体_Grey_灰色.step

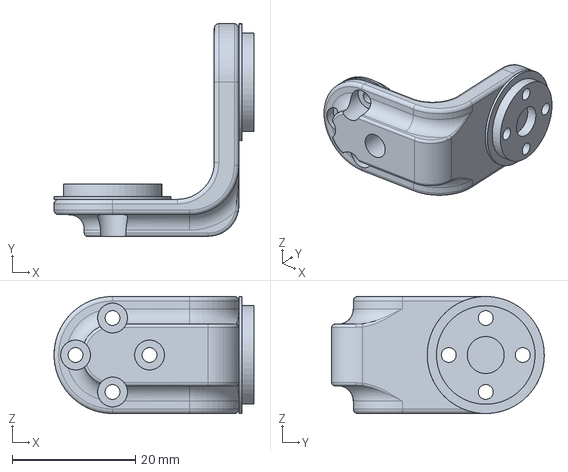
[picture p26: CAD file, 2026-11-04]
Structure/Print/STEP/03_Grey_灰色_16件/13_左胯侧摆_连续实体_Grey_灰色.step
32.5 x 34.5 x 19.0 mm
