deanxizian/MicroDuck-Replica/Hardware/HAT-D1-HD1910/KiCad/models/CONN-TH_DB125-2.54-2P-GN.step

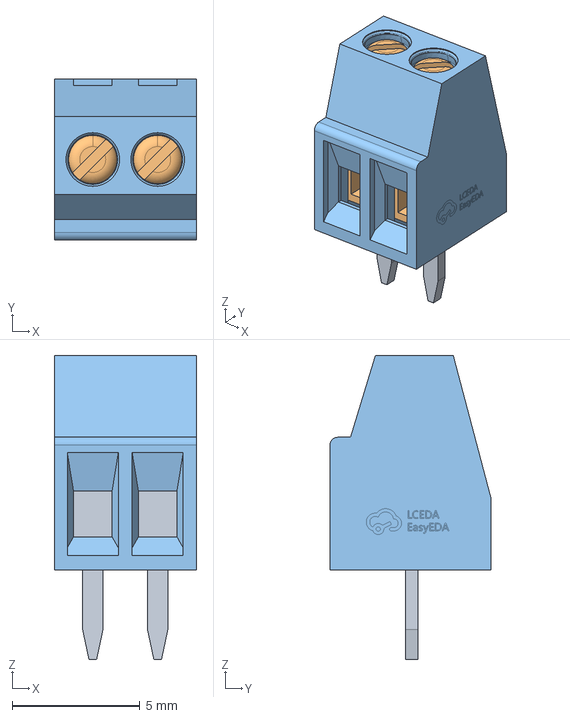
[picture p27: CAD file, 2026-11-04]
Hardware/HAT-D1-HD1910/KiCad/models/CONN-TH_DB125-2.54-2P-GN.step
5.56 x 6.30 x 11.9 mm
