deanxizian/MicroDuck-Replica/Hardware/IMU-AMP2.0/KiCad/models/SOT-23-5_L2.9-W1.6-H1.1-LS2.8-P0.95.step

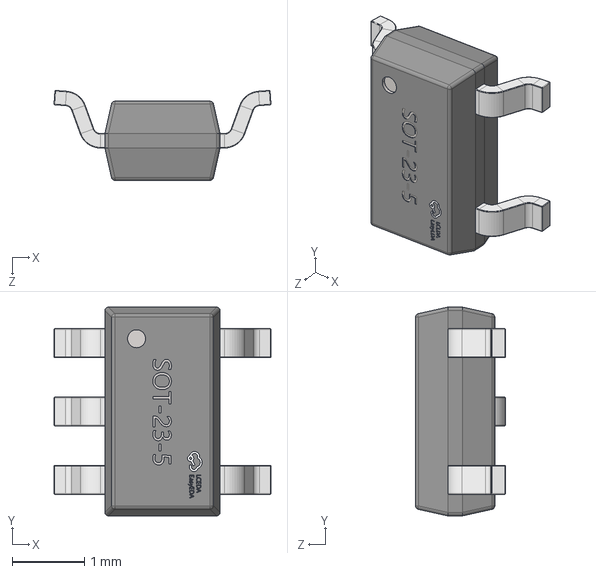
[picture p28: CAD file, 2026-11-04]
Hardware/IMU-AMP2.0/KiCad/models/SOT-23-5_L2.9-W1.6-H1.1-LS2.8-P0.95.step
3.01 x 2.90 x 1.25 mm
