deanxizian/MicroDuck-Replica/Structure/Print/STEP/01_9000HE_白色_8件/09_左胯外盖_深装柱_9000HE_白色_v3.1.step

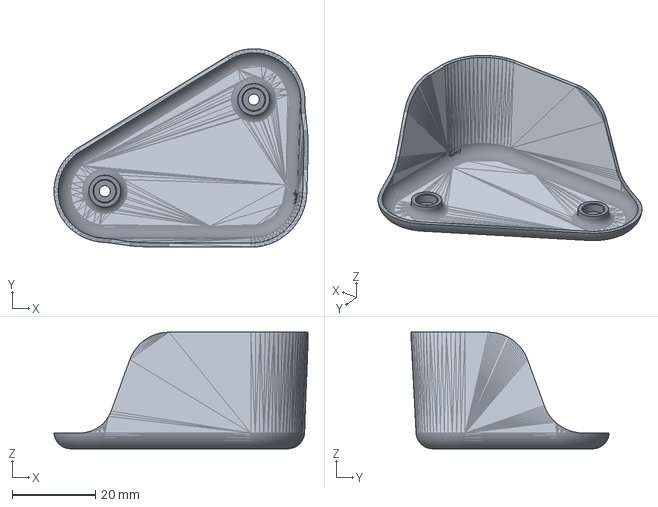
[picture p29: CAD file, 2026-11-04]
Structure/Print/STEP/01_9000HE_白色_8件/09_左胯外盖_深装柱_9000HE_白色_v3.1.step
61.0 x 47.7 x 28.0 mm
