deanxizian/MicroDuck-Replica/Hardware/HAT-D1-HD1910/KiCad/models/MIC-SMD_4P-L2.8-W1.9-H1.0-P1.84-TL.step

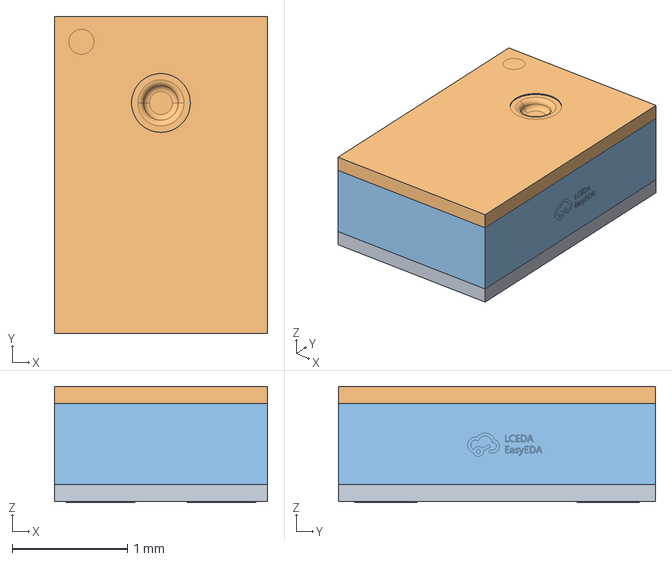
[picture p30: CAD file, 2026-11-04]
Hardware/HAT-D1-HD1910/KiCad/models/MIC-SMD_4P-L2.8-W1.9-H1.0-P1.84-TL.step
1.85 x 2.75 x 1.01 mm
