deanxizian/MicroDuck-Replica/Hardware/IMU-AMP2.0/KiCad/models/LGA-14_L3.0-W2.5-P0.50-BR.step

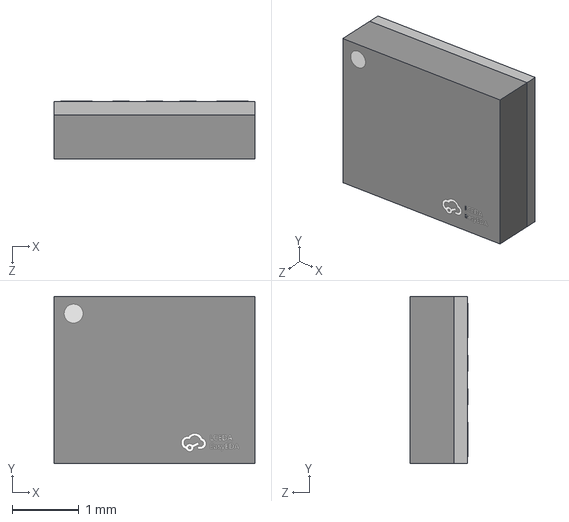
[picture p31: CAD file, 2026-11-04]
Hardware/IMU-AMP2.0/KiCad/models/LGA-14_L3.0-W2.5-P0.50-BR.step
3.00 x 2.50 x 0.871 mm
