deanxizian/MicroDuck-Replica/Structure/Print/STEP/03_Grey_灰色_16件/08_右膝支撑_Grey_灰色.step

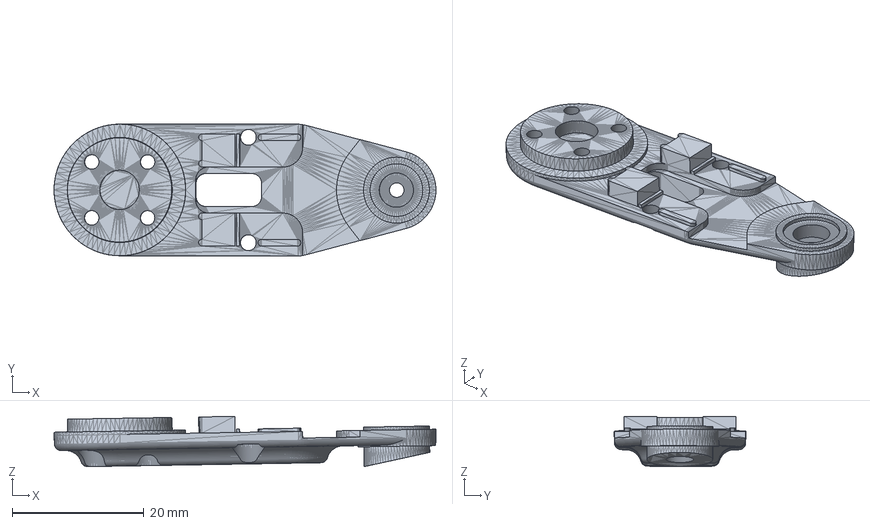
[picture p32: CAD file, 2026-11-04]
Structure/Print/STEP/03_Grey_灰色_16件/08_右膝支撑_Grey_灰色.step
58.0 x 20.0 x 7.63 mm
