deanxizian/MicroDuck-Replica/Hardware/IMU-AMP2.0/KiCad/models/TSSOP-20_L6.5-W4.4-H1.0-LS6.4-P0.65.step

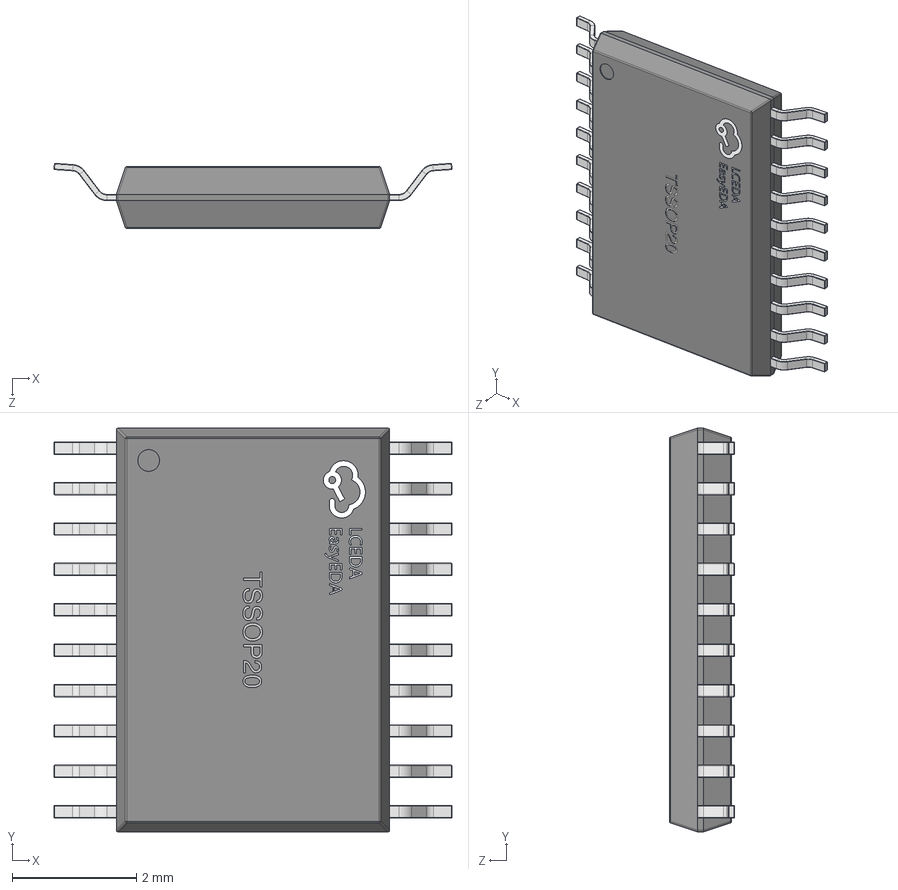
[picture p33: CAD file, 2026-11-04]
Hardware/IMU-AMP2.0/KiCad/models/TSSOP-20_L6.5-W4.4-H1.0-LS6.4-P0.65.step
6.41 x 6.50 x 1.05 mm
