deanxizian/MicroDuck-Replica/Structure/Print/STEP/01_9000HE_白色_8件/32_头部集成盖_兼容hat插口_9000HE_白色.step

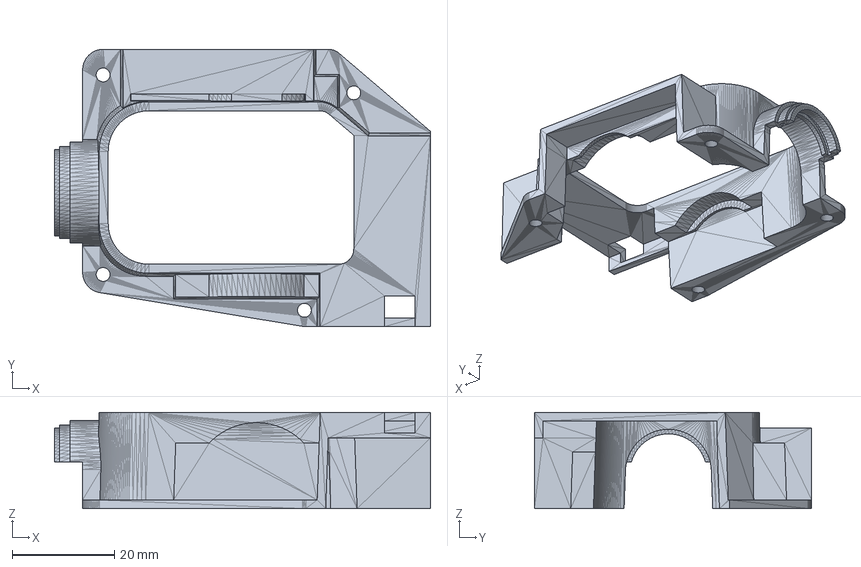
[picture p34: CAD file, 2026-11-04]
Structure/Print/STEP/01_9000HE_白色_8件/32_头部集成盖_兼容hat插口_9000HE_白色.step
73.5 x 54.2 x 18.8 mm
