deanxizian/MicroDuck-Replica/Structure/Print/STEP/03_Grey_灰色_16件/17_左胯固定片_Grey_灰色.step

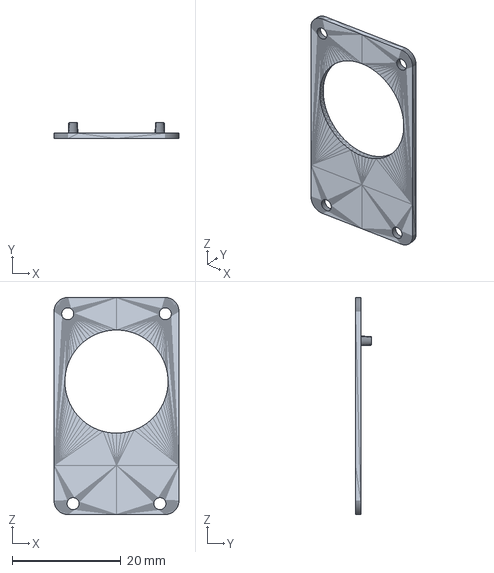
[picture p35: CAD file, 2026-11-04]
Structure/Print/STEP/03_Grey_灰色_16件/17_左胯固定片_Grey_灰色.step
23.0 x 3.00 x 40.0 mm
