deanxizian/MicroDuck-Replica/Hardware/IMU-AMP2.0/KiCad/models/US-8_L2.0-W2.3-H0.9-LS3.1-P0.50.step

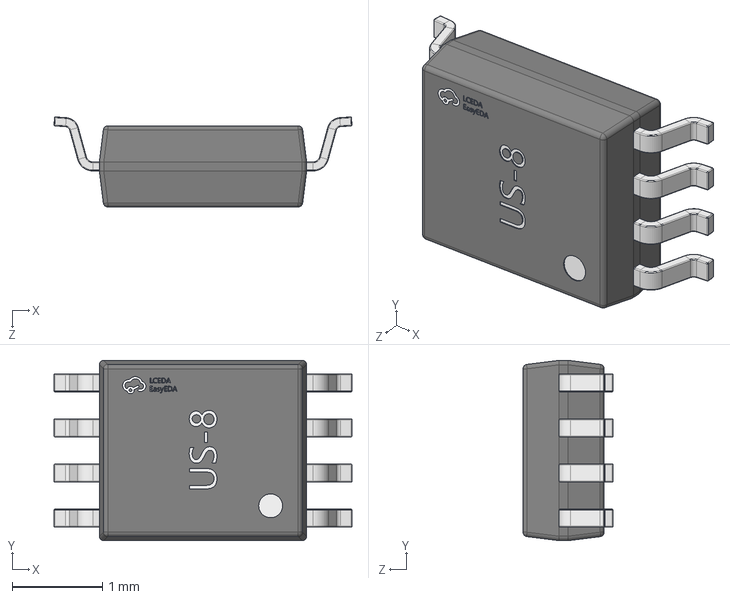
[picture p36: CAD file, 2026-11-04]
Hardware/IMU-AMP2.0/KiCad/models/US-8_L2.0-W2.3-H0.9-LS3.1-P0.50.step
3.31 x 2.00 x 1.00 mm
