deanxizian/MicroDuck-Replica/Structure/Print/STEP/01_9000HE_白色_8件/28_左壳_连续孔口_9000HE_白色_v3.1.step

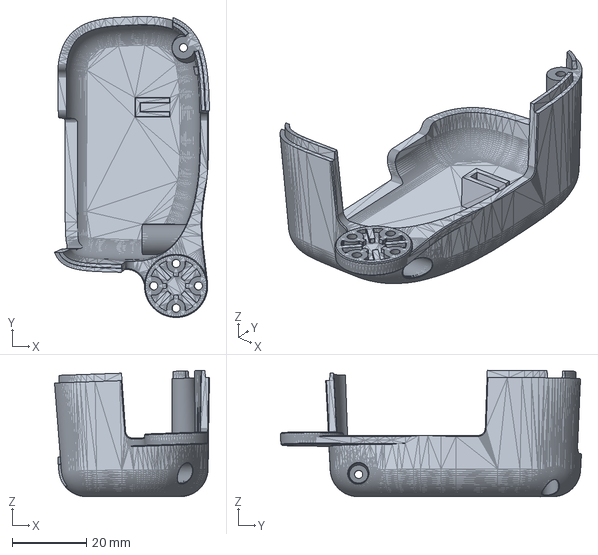
[picture p37: CAD file, 2026-11-04]
Structure/Print/STEP/01_9000HE_白色_8件/28_左壳_连续孔口_9000HE_白色_v3.1.step
41.7 x 80.9 x 34.0 mm
