deanxizian/MicroDuck-Replica/Hardware/IMU-AMP2.0/KiCad/models/SOD-323_L1.7-W1.3-LS2.7-BI.step

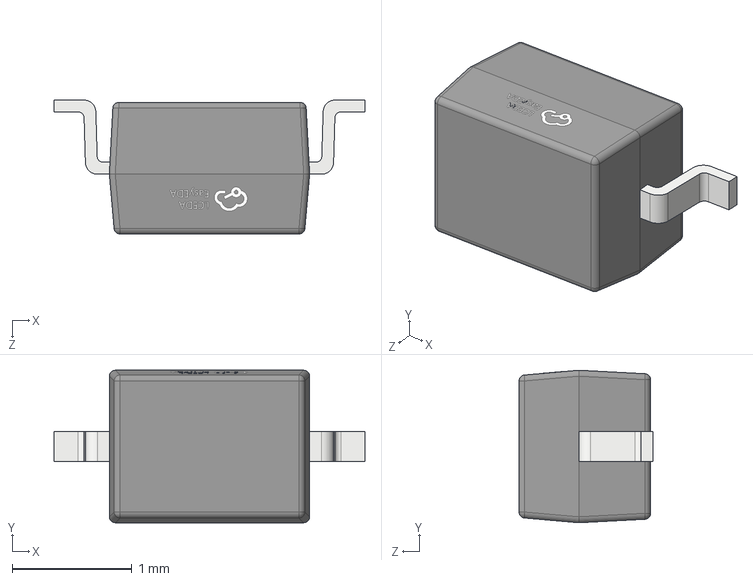
[picture p38: CAD file, 2026-11-04]
Hardware/IMU-AMP2.0/KiCad/models/SOD-323_L1.7-W1.3-LS2.7-BI.step
2.60 x 1.28 x 1.12 mm
