deanxizian/MicroDuck-Replica/Structure/Print/STEP/03_Grey_灰色_16件/05_左脚_Grey_灰色.step

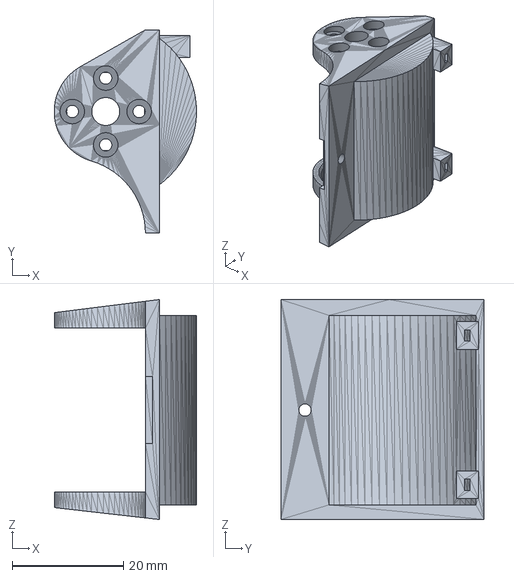
[picture p39: CAD file, 2026-11-04]
Structure/Print/STEP/03_Grey_灰色_16件/05_左脚_Grey_灰色.step
25.5 x 36.5 x 39.5 mm
