deanxizian/MicroDuck-Replica/Hardware/IMU-AMP2.0/KiCad/models/HDR-TH_5P-P2.54-M-LI-1X5P.step

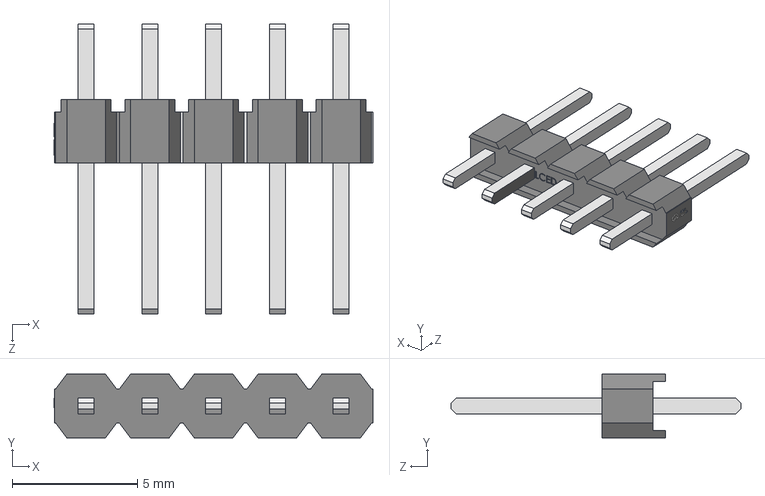
[picture p40: CAD file, 2026-11-04]
Hardware/IMU-AMP2.0/KiCad/models/HDR-TH_5P-P2.54-M-LI-1X5P.step
12.7 x 2.54 x 11.5 mm
