deanxizian/MicroDuck-Replica/Structure/Print/STEP/03_Grey_灰色_16件/24_嘴巴_Grey_灰色.step

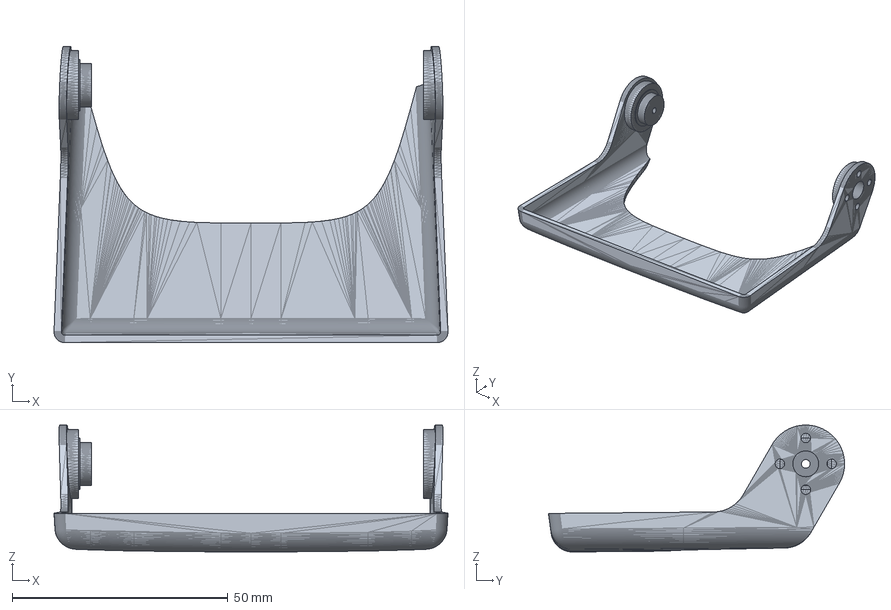
[picture p41: CAD file, 2026-11-04]
Structure/Print/STEP/03_Grey_灰色_16件/24_嘴巴_Grey_灰色.step
91.4 x 68.7 x 29.4 mm
