deanxizian/MicroDuck-Replica/Structure/Print/STEP/03_Grey_灰色_16件/26_头部集成板_张嘴让位端缘修整_Grey_灰色_v3.1.step

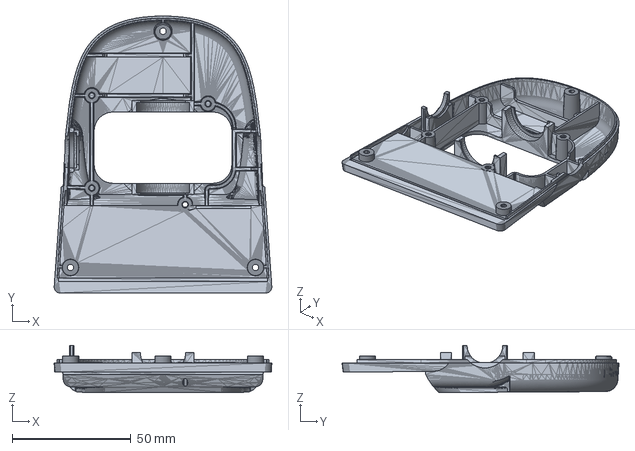
[picture p42: CAD file, 2026-11-04]
Structure/Print/STEP/03_Grey_灰色_16件/26_头部集成板_张嘴让位端缘修整_Grey_灰色_v3.1.step
91.8 x 116.7 x 19.9 mm
