deanxizian/MicroDuck-Replica/Structure/Print/STEP/03_Grey_灰色_16件/21_头部旋转_叉架29.2_Grey_灰色.step

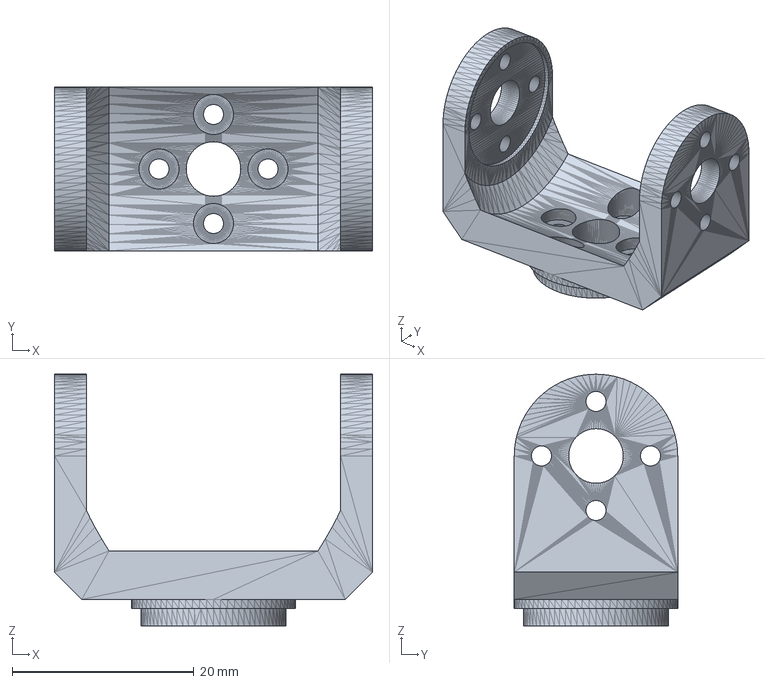
[picture p43: CAD file, 2026-11-04]
Structure/Print/STEP/03_Grey_灰色_16件/21_头部旋转_叉架29.2_Grey_灰色.step
35.0 x 18.0 x 27.7 mm
