deanxizian/MicroDuck-Replica/Structure/Print/STEP/03_Grey_灰色_16件/22_头部侧倾_Grey_灰色_v3.1.step

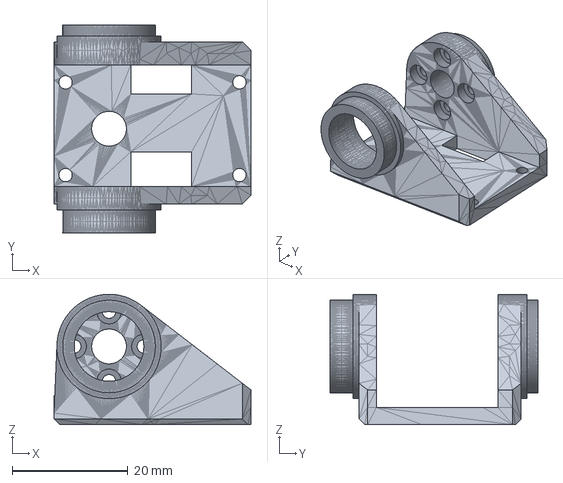
[picture p44: CAD file, 2026-11-04]
Structure/Print/STEP/03_Grey_灰色_16件/22_头部侧倾_Grey_灰色_v3.1.step
34.0 x 35.9 x 22.5 mm
