deanxizian/MicroDuck-Replica/(list of files, cad)

Other CAD files:
Peripherals/Camera/Waveshare-RPi-Camera-E-F-G-H.dwg
Structure/Print/STEP/01_9000HE_白色_8件/03_左脚掌_9000HE_白色.step
Structure/Print/STEP/04_TPU95A_黑色_2件/01_左脚底_TPU95A_黑色.step
Structure/Print/STEP/03_Grey_灰色_16件/15_左胯旋转_Grey_灰色.step
Structure/Print/STEP/03_Grey_灰色_16件/20_颈部固定右_Grey_灰色.step
Structure/Print/STEP/01_9000HE_白色_8件/10_右胯外壳_深装柱_9000HE_白色.step
Structure/Print/STEP/03_Grey_灰色_16件/18_右胯固定片_Grey_灰色.step
Structure/Print/STEP/03_Grey_灰色_16件/06_右脚_Grey_灰色.step
Structure/Print/STEP/03_Grey_灰色_16件/07_左膝支撑_Grey_灰色.step
Structure/Blender/MicroDuck-Replica_Colorful.blend
Structure/Blender/MicroDuck-Replica_Print-Colors.blend
Structure/Print/STL/01_9000HE_白色_8件/03_左脚掌_9000HE_白色.stl
Structure/Print/STL/01_9000HE_白色_8件/04_右脚掌_9000HE_白色.stl
Structure/Print/STL/01_9000HE_白色_8件/09_左胯外盖_深装柱_9000HE_白色_v3.1.stl
Structure/Print/STL/01_9000HE_白色_8件/10_右胯外壳_深装柱_9000HE_白色.stl
Structure/Print/STL/01_9000HE_白色_8件/25_头盖_双麦_短扬声器粘贴面_9000HE_白色_v3.1.stl
Structure/Print/STL/01_9000HE_白色_8件/28_左壳_连续孔口_9000HE_白色_v3.1.stl
Structure/Print/STL/01_9000HE_白色_8件/29_右壳_连续孔口_9000HE_白色_v3.1.stl
Structure/Print/STL/01_9000HE_白色_8件/32_头部集成盖_兼容hat插口_9000HE_白色.stl
Structure/Print/STL/02_JLCBlack_黑色_3件/23_脸板_相机柱6.3_ToF横装等高_JLCBlack_黑色.stl
Structure/Print/STL/02_JLCBlack_黑色_3件/27_眼睛_厚6mm_JLCBlack_黑色.stl
Structure/Print/STL/02_JLCBlack_黑色_3件/31_电池仓_右侧出线缺口_JLCBlack_黑色_v3.1.stl
Structure/Print/STL/03_Grey_灰色_16件/05_左脚_Grey_灰色.stl
Structure/Print/STL/03_Grey_灰色_16件/06_右脚_Grey_灰色.stl
Structure/Print/STL/03_Grey_灰色_16件/07_左膝支撑_Grey_灰色.stl
Structure/Print/STL/03_Grey_灰色_16件/08_右膝支撑_Grey_灰色.stl
Structure/Print/STL/03_Grey_灰色_16件/13_左胯侧摆_连续实体_Grey_灰色.stl
Structure/Print/STL/03_Grey_灰色_16件/14_右胯侧摆_连续实体_Grey_灰色.stl
Structure/Print/STL/03_Grey_灰色_16件/15_左胯旋转_Grey_灰色.stl
Structure/Print/STL/03_Grey_灰色_16件/16_右胯旋转_Grey_灰色.stl
Structure/Print/STL/03_Grey_灰色_16件/17_左胯固定片_Grey_灰色.stl
Structure/Print/STL/03_Grey_灰色_16件/18_右胯固定片_Grey_灰色.stl
Structure/Print/STL/03_Grey_灰色_16件/19_颈部固定左_Grey_灰色.stl
Structure/Print/STL/03_Grey_灰色_16件/20_颈部固定右_Grey_灰色.stl
Structure/Print/STL/03_Grey_灰色_16件/21_头部旋转_叉架29.2_Grey_灰色.stl
Structure/Print/STL/03_Grey_灰色_16件/22_头部侧倾_Grey_灰色_v3.1.stl
Structure/Print/STL/03_Grey_灰色_16件/24_嘴巴_Grey_灰色.stl
Structure/Print/STL/03_Grey_灰色_16件/26_头部集成板_张嘴让位端缘修整_Grey_灰色_v3.1.stl
Structure/Print/STL/04_TPU95A_黑色_2件/01_左脚底_TPU95A_黑色.stl
Structure/Print/STL/04_TPU95A_黑色_2件/02_右脚底_TPU95A_黑色.stl
