deanxizian/MicroDuck-Replica/Structure/Print/STEP/README.md

# STEP · 仅供参考

共 29 件，单位 mm。13、14 号为解析曲面 BRep；其余 27 件为由最终 STL 转换的分面 BRep，不是完整参数化 CAD 特征树。

**嘉立创转换该 STEP 包时仍出现多壳体、坏边或反向面告警；目前不要使用这套 STEP 下单。** 打印应选相邻 [STL](../STL/) 目录。

保留这些文件用于 CAD 查看、测量和后续重建。清单中记录表示类型、文件 SHA256 和对应 STL 的 SHA256：[manifest.json](manifest.json)。
