deanxizian/MicroDuck-Replica/Docs/VALIDATION.md

# 验证状态 · 2026-11-06

| 项目 | 检查结果 | 待完成 |
| --- | --- | --- |
| 29 件 STL | 单一闭合网格、法线一致，无坏边、非流形、退化面、自交 | 实物公差、强度与寿命测试 |
| 嘉立创 STL 复检 | 09、22、25、26、28、29、31 的网格项通过，文件未变；23、27 号修订件已重新下单 | 23、27 号平台复检详情尚未归档；25/26 仍为易变形结构 |
| STEP | 29 份 CAD 参考，13/14 解析 BRep，其余分面 BRep | 平台转换仍有告警；不用于当前 JLC 下单 |
| 两份 Blender | 同源几何、位置、父子关系与完整外设装配；PCB 板面绿色、相机 PCB 黑色、双面胶白色，保存后重开核对 | 未校准实物色差 |
| 铁头 TNP-F550-GN | 按官方 70.6×38.6×20.5 mm 外包络更新，两份 Blender 同步 | 曲面和纵槽按照片近似；接口沿用参考尺寸，卡口/接触孔及实物配合待测 |
| 活动嘴部 | 0–35° 采样检查，30° 名义间隙约 0.35 mm | 实物运动与线束测试；网格清理后的整机全关节扫掠 |
| 相机与 ToF | 按实测孔距 21×13.5 mm、PCB 约 1.6 mm、背板至黑色镜筒前端约 14.5 mm 修订；相机柱高 6.3 mm、整体后移 2 mm、PCB 与安装柱旋转 90°，ToF 横装、焊盘朝下且中心等高；局部静态装配检查通过；27 号眼圈厚度 6 mm | 玻璃、连接器和 ToF 板厚仍为参考尺寸；上壳进入保守 160° 视锥，实物固定、边缘遮挡与排线待验证；相机画面需转回正向，ToF 分区方向需按 180° 安装方向校正 |
| 镜头前倒保护 | 固定头部与平整地面几何检查：参考玻璃最小余量约 0.65 mm | 玻璃凸起未实测；尚未进行冲击、变形或不平地面测试 |
| 板卡 | 现有安装位置与空间核对；采购 SKU 已列入 BOM | 外购 D1 HAT／kissqy HUB 的实物改版、连接器和版号待核对 |
| Banana | 本地 ERC/DRC 和网络记录；制造文件已导出 | PPTC 替代型号、接触针、公差、温升和保护功能未实测 |
| D1 HAT | KiCad 与 Gerber / BOM / CPL 参考 | 存在 J4 DRC、选料及贴装确认项 |
| kissqy HAT / IMU | 源工程导入一致性检查与制造导出 | 全面生产审核、成品版本核对 |

## 文件追溯

[STL manifest](../Structure/Print/STL/manifest.json) 记录材料、数量与 SHA256；对应 [本地网格检查](../Structure/Verification/stl-mesh-audit.json) 和 [平台复检摘要](../Structure/Verification/jlc-stl-recheck.json)。

[镜头保护修订](../Structure/Verification/camera-protection-update.json) 保存当前 23/27 号、间隙与接地几何结果；[相机旋转与 ToF 横装记录](../Structure/Verification/camera-tof-horizontal-update.json) 为上一版；此前尺寸核对见 [相机与脸板修订记录](../Structure/Verification/camera-face-update.json)；早期装配记录保留在 [Blender 初版核对](../Structure/Verification/blender-publication.json)。[SHA256SUMS](../SHA256SUMS) 用于目录完整性校验。

## 嘉立创薄结构反馈

| 零件 | 局部尺寸 | 当前处理 |
| --- | --- | --- |
| 23 脸板 ToF 盲孔底 | 约 0.3 → 1.3 mm | 已加厚并保留；相机孔底约 1.4 mm，脸板主体仍为 1.3 mm |
| 06 右脚轴承唇边／倒角交界 | 约 0.20–0.23 mm | 保留原结构，未消除风险 |
| 07、08 膝支撑小端孔底 | 约 0.50 mm | 保留原结构，未消除风险 |
| 13、14 胯侧摆舵盘外沿 | 约 0.50 mm | 保留原结构，未消除风险 |
| 31 电池仓槽旁窄筋 | 宽约 0.55–0.56 mm | 保留原结构，未消除风险 |

未修改件的文件哈希与 11 月 4 日测量版本一致。上述为局部几何尺寸；网格检查通过不代表强度、翘曲或装配公差已通过实物验证。
