deanxizian/MicroDuck-Replica/Docs/CHANGES.md

# 本版修改记录

相机与 ToF 更新（2026-11-06）：按实测尺寸修订摄像头模型，更新 23、27 号 STL、STEP 和两套完整 Blender。23 号相机柱高 6.3 mm，相机后移 2 mm；27 号眼圈厚度改为 6 mm。两件已重新下单，BOM 以新版本和价格替换旧件。

装配配色更新（2026-11-06）：双面胶改为白色；各板卡 PCB 板面改为绿色，摄像头 PCB 为黑色。两套 Blender 与首页预览同步。

采购与资料更新（2026-11-06）：咪头改为带 2P 1.25 mm 插头版，SH1.0 线改为 4P、10 cm 双头线，剪去一端插头后焊接 ToF；删除重复采购的相机排线和旧沣标电池资料。

目录整理（2026-11-04）：BOM 按结构件、电路板、外设和耗材分类；硬件资料统一为 `JLC`、`KiCad`、`Verification` 与 `README.md`。

采购更新（2026-11-04）：BOM 补齐购物车 SKU、数量、价格和打印费用；区分本机 4GB＋32GB 无排针 ZERO 3W 与推荐 2GB 无 eMMC 带排针方案；说明 Banana 裸板的 PTC、取电针与引线需自行焊接。

电池更新（2026-11-04）：选用铁头绿色 TNP-F550-GN 3500mAh；两套 Blender 同步更新外形、尺寸和颜色，附官方说明书。29 件打印文件不变；电池接口仍待实测。

## 结构与装配

- 使用 kissqy 实际 STL 装配并修正舵机舵盘配置，保留真实外购件；11、12、30 号采用金属成品。
- 21 号颈部叉架调整到 29.2 mm 的配合跨度；09/10 号腿壳修改安装柱深度，保留外壳包裹关系。
- 25/26 号配对螺丝连接柱整体外移 0.6 mm，为背轴留位。
- 25 号增加左右 Ø4.4 麦克风压入座与 Ø1.5 拾音孔；扬声器朝下、背部贴 2.5 mm 胶，内壁局部填平，缩短粘贴面；通风槽避开梁。
- 23 号相机安装孔距为实测 21 × 13.5 mm，安装柱旋转 90°、柱高 6.3 mm；摄像头 PCB 厚约 1.6 mm，PCB 背面到黑色镜筒前端约 14.5 mm。ZERO 3W 的四个安装柱向下调整 1.5 mm。
- ToF 横放，安装台阶与模块转向 180° 后上移 2 mm，焊盘朝下、感光中心与相机等高；ToF 盲孔底由约 0.3 mm 加厚到 1.3 mm。
- 27 号眼圈正面减薄 2 mm，相机同步后移 2 mm。平整地面的静态几何检查保留约 0.65 mm 余量；玻璃凸起尚未实测，广角边缘遮挡需装机实拍确认。
- 26 号按规则平面、切削与圆角关系重建，调整活动嘴部的运动让位并处理端缘缺口；25 号保留已接受外观版本。
- 13/14 号重建连续实体；28/29 号修整连续孔口与表面；31 号保留 Banana 卡槽及右侧出线缺口，定位余量 0.1 mm、入口余量 0.2 mm。
- 补齐电池、双麦、扬声器、相机、ToF、ZERO 3W、HAT、IMU、Banana、HUB，并校正 HUB 支座落座。

## 网格与输出

29 件 STL 已逐件完成本地检查，09、22、25、26、28、29、31 号通过嘉立创网格复检。22 号在平台修复后继续清理自交，其余六件在本地修复。七件修复前后的双向顶点到表面采样偏差均小于 0.012 mm，壁厚保持不变。

当前打印包为 v3.6，仅 23、27 号替换为本次修订件，其余 27 件保持 v3.1 文件。两套配色使用相同装配。修订件已下单，平台复检详情尚未归档。STEP 转换告警仍存在，仅供 CAD 参考，打印使用 STL。
