deanxizian/MicroDuck-Replica/Hardware/HAT-AMP2.0/JLC/schematic.pdf

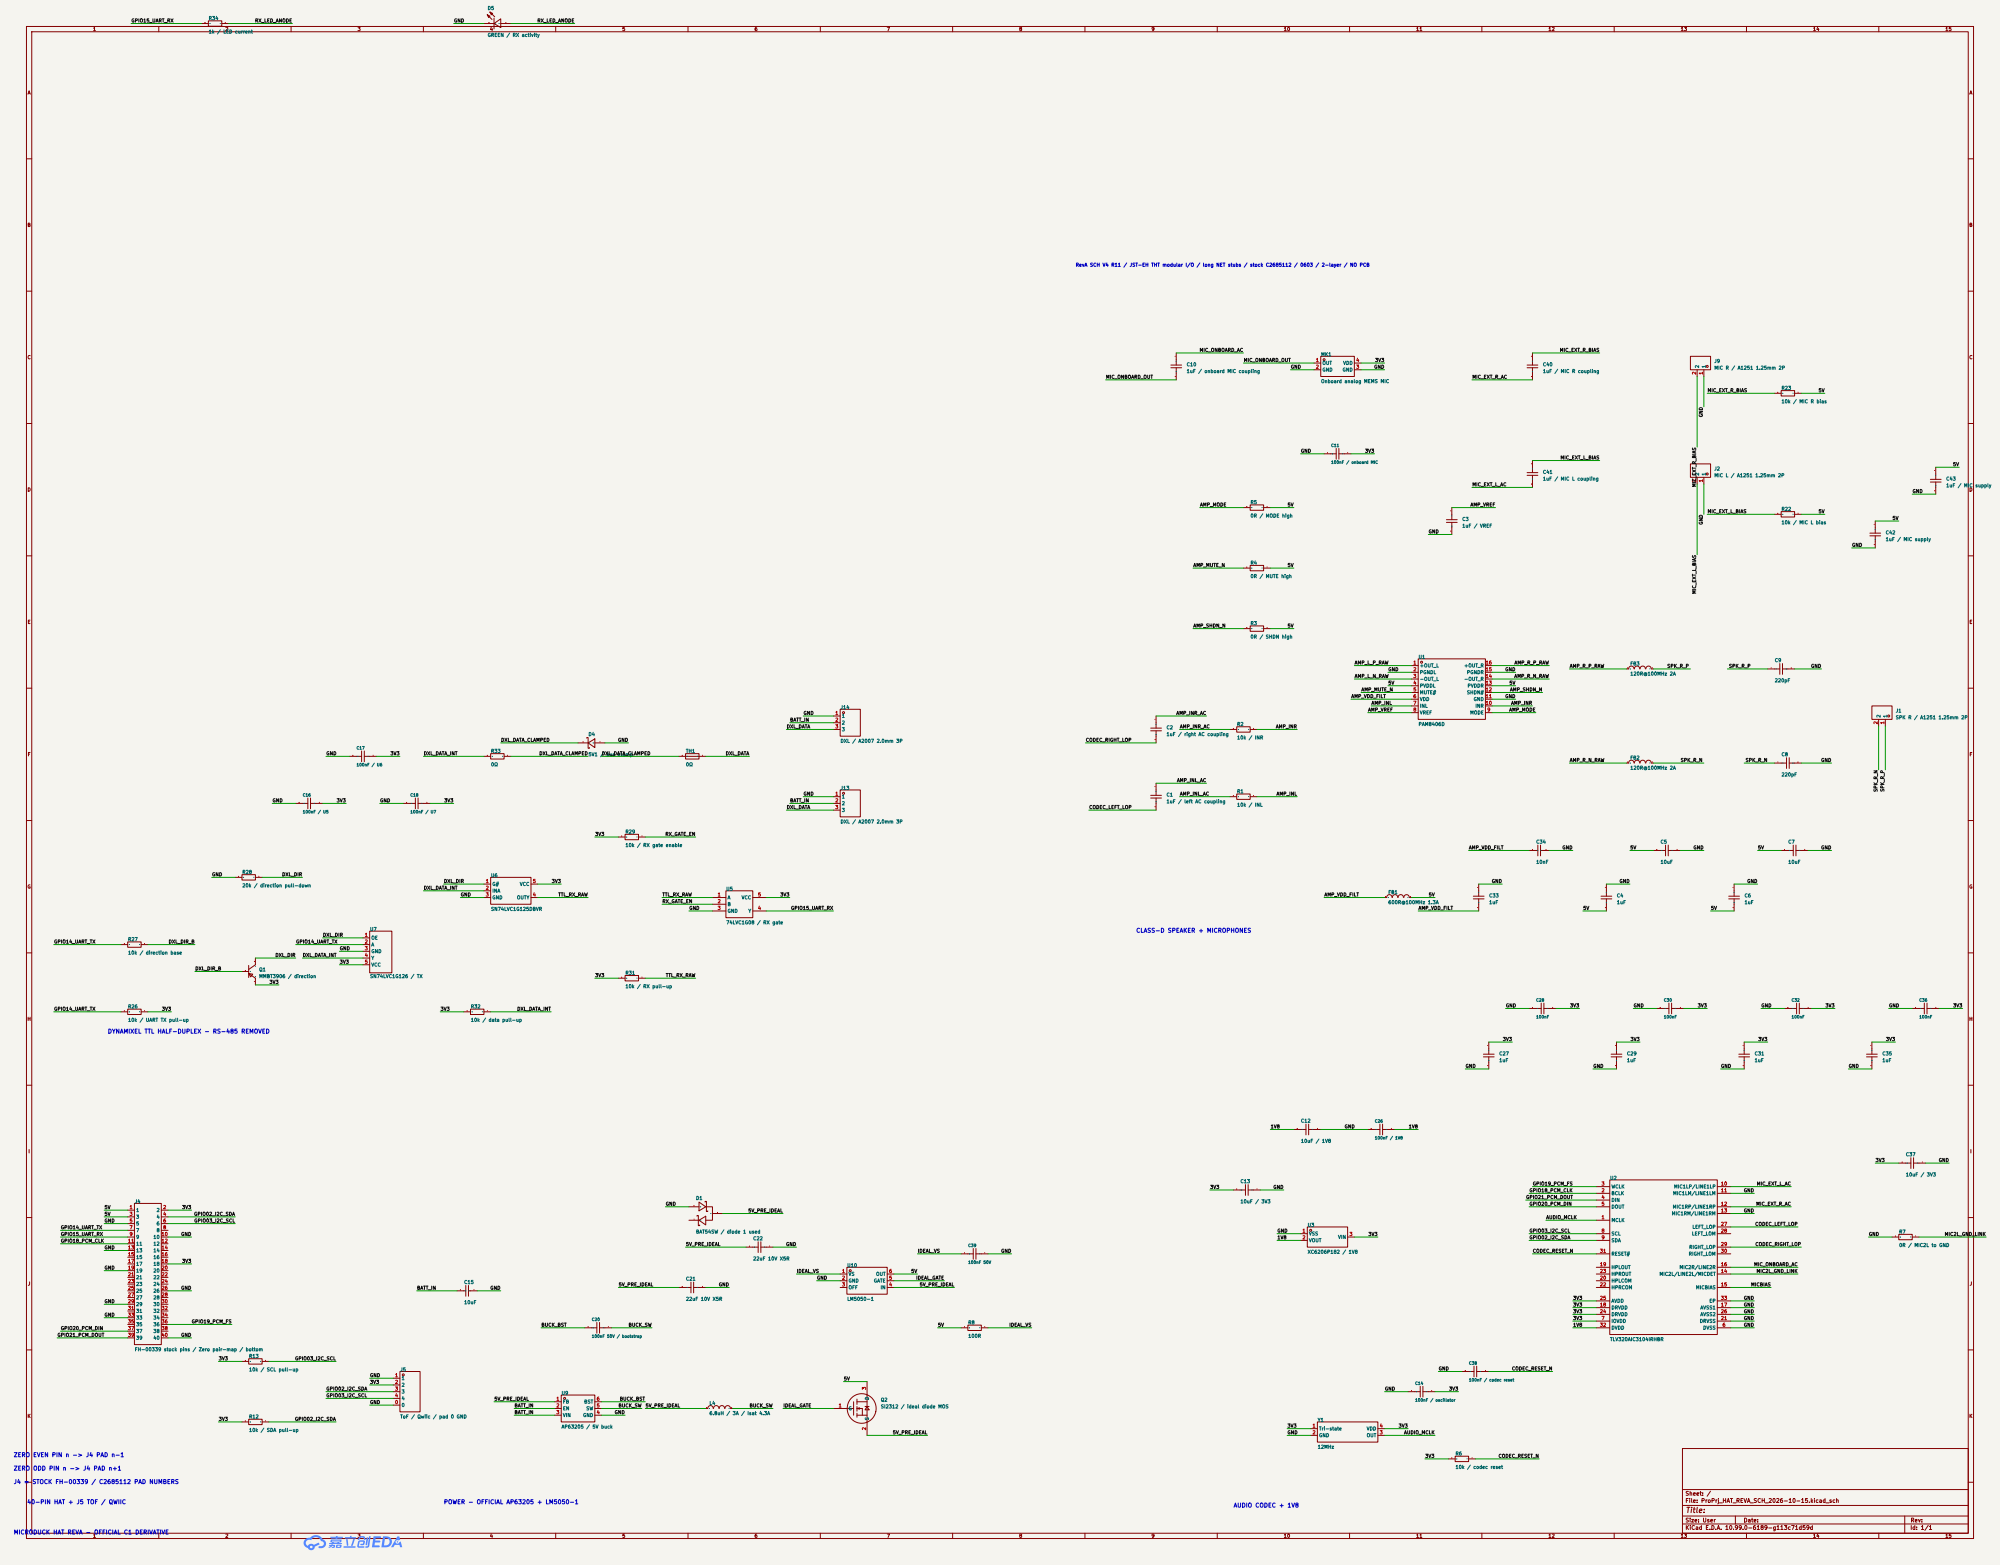
[picture p45: page 1]

RevA SCH V4 R11 / JST-EH THT modular I/O / long NET stubs / stock C2685112 / 0603 / 2-layer / NO PCB

4 MK1 Onboard analog MEMS MIC
5V5VGND

10k / UART TX pull-up

DYNAMIXEL TTL HALF-DUPLEX - RS-485 REMOVED

FH-00339 stock pins / Zero pair-map / bottom

ToF / Qwiic / pad 0 GND

ZERO EVEN PIN n -> J4 PAD n-1

ZERO ODD PIN n -> J4 PAD n+1

J4 = STOCK FH-00339 / C2685112 PAD NUMBERS

40-PIN HAT + J5 TOF / QWIIC

Size: User | Rev:
KiCad E.D.A. 10.99.0-6189-g113c71d59d | Id: 1/1

MICRODUCK HAT REVA - OFFICIAL C1 DERIVATIVE
