deanxizian/MicroDuck-Replica/Hardware/IMU-AMP2.0/JLC/schematic.pdf

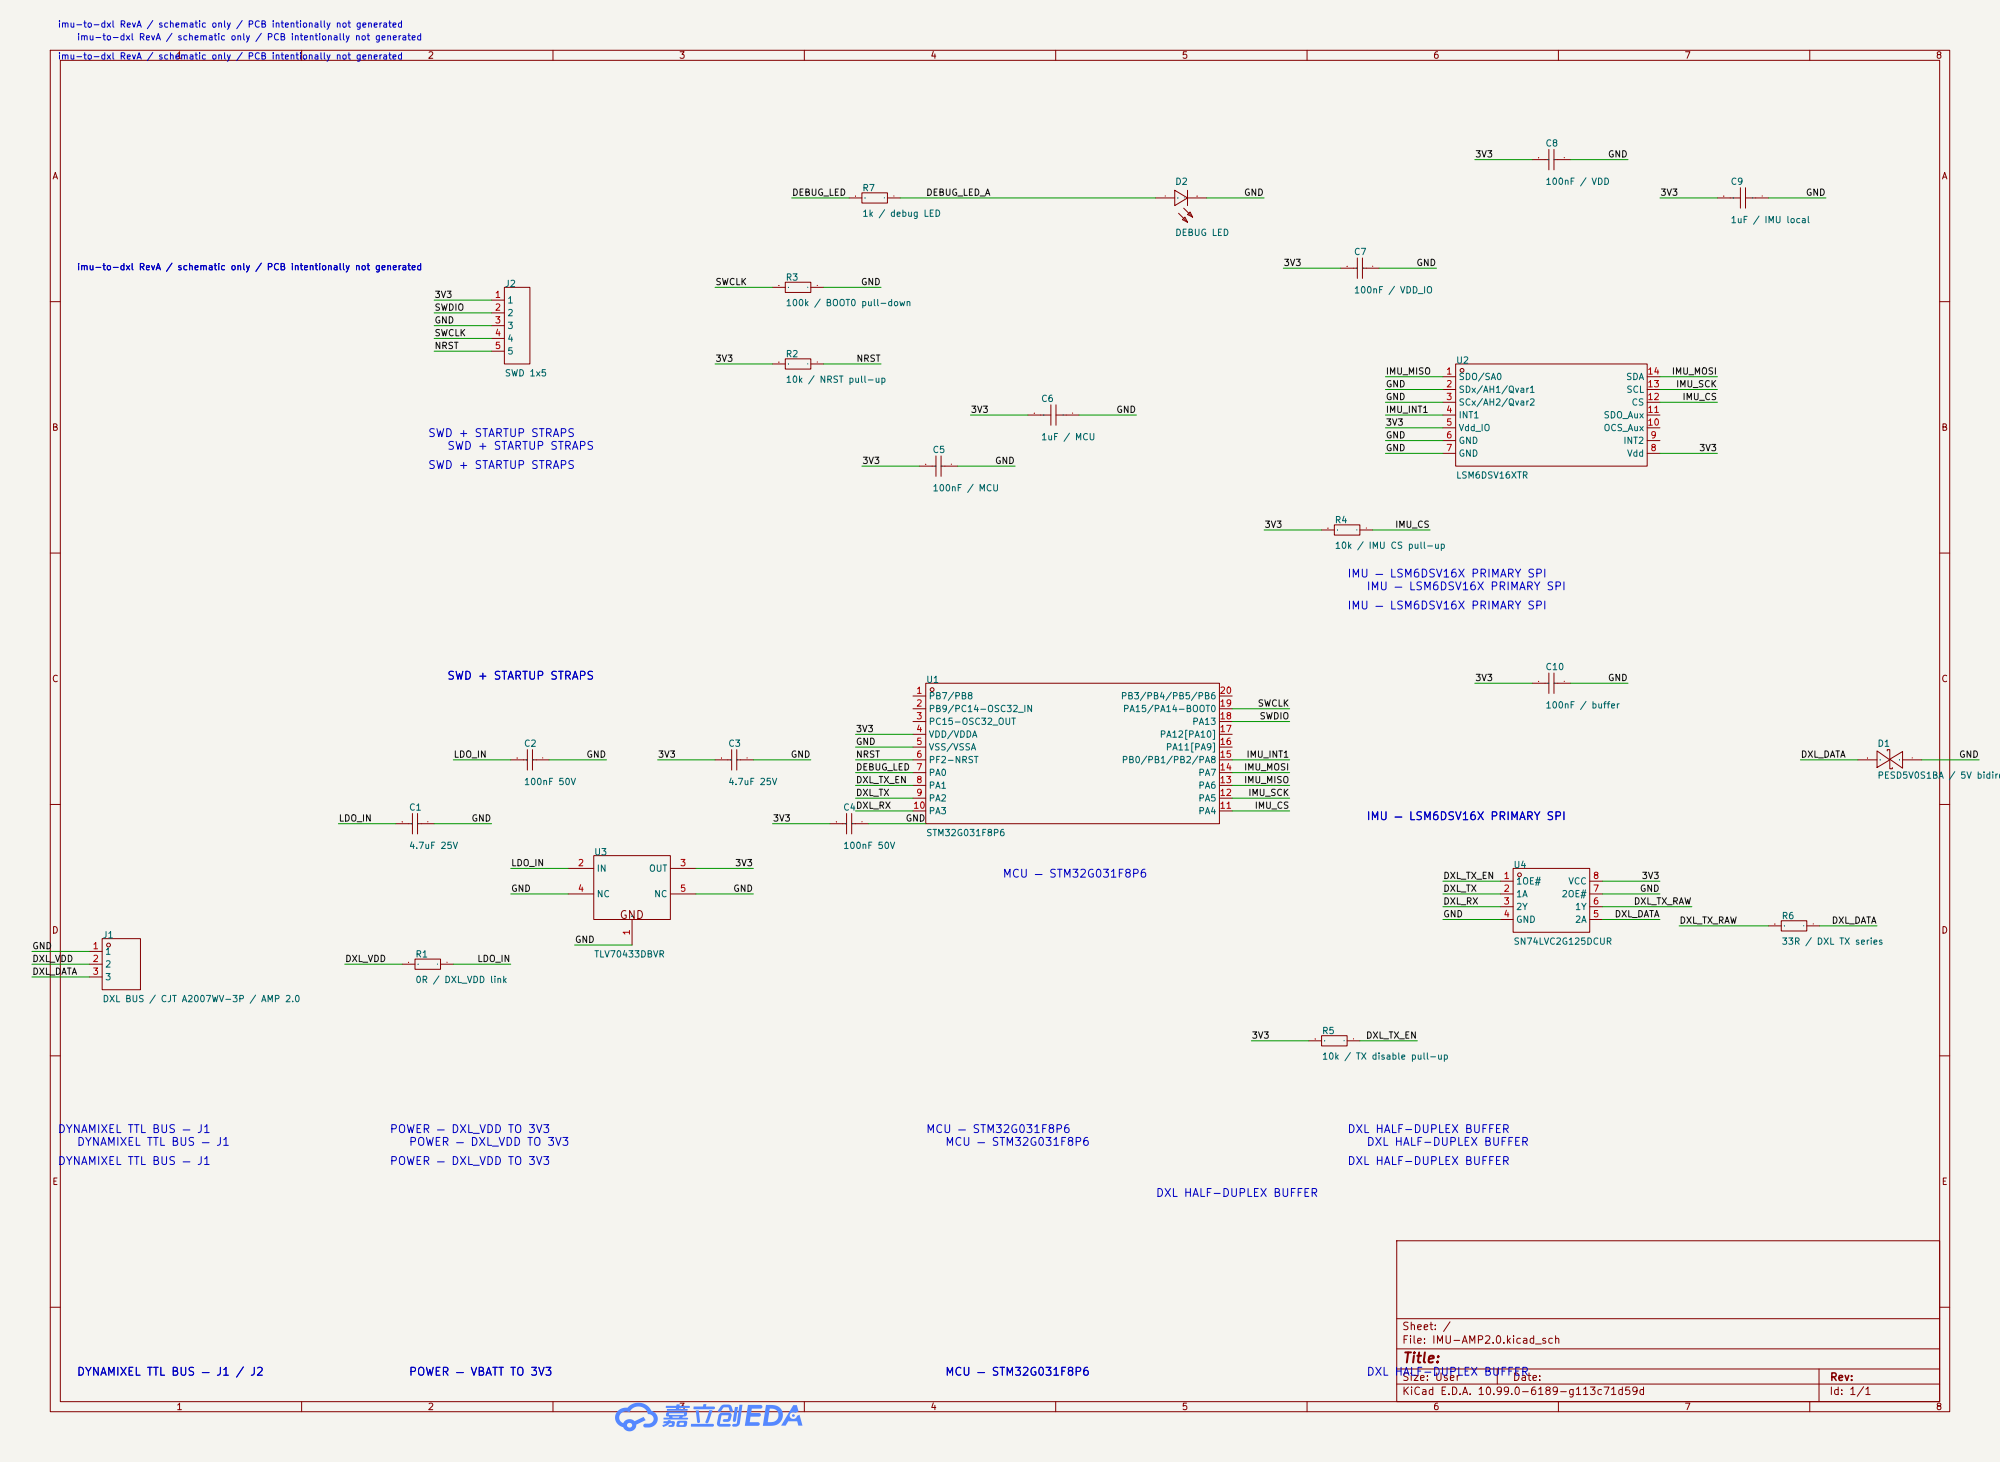
[picture p46: page 1]

imu-to-dxl RevA / schematic only / PCB intentionally not generated

10k / IMU CS pull-up

10k / TX disable pull-up

DXL HALF-DUPLEX BUFFER

Size: User | Rev:
KiCad E.D.A. 10.99.0-6189-g113c71d59d | Id: 1/1
