deanxizian/MicroDuck-Replica/Peripherals/Battery/Tilta-NP-F550-manual.pdf

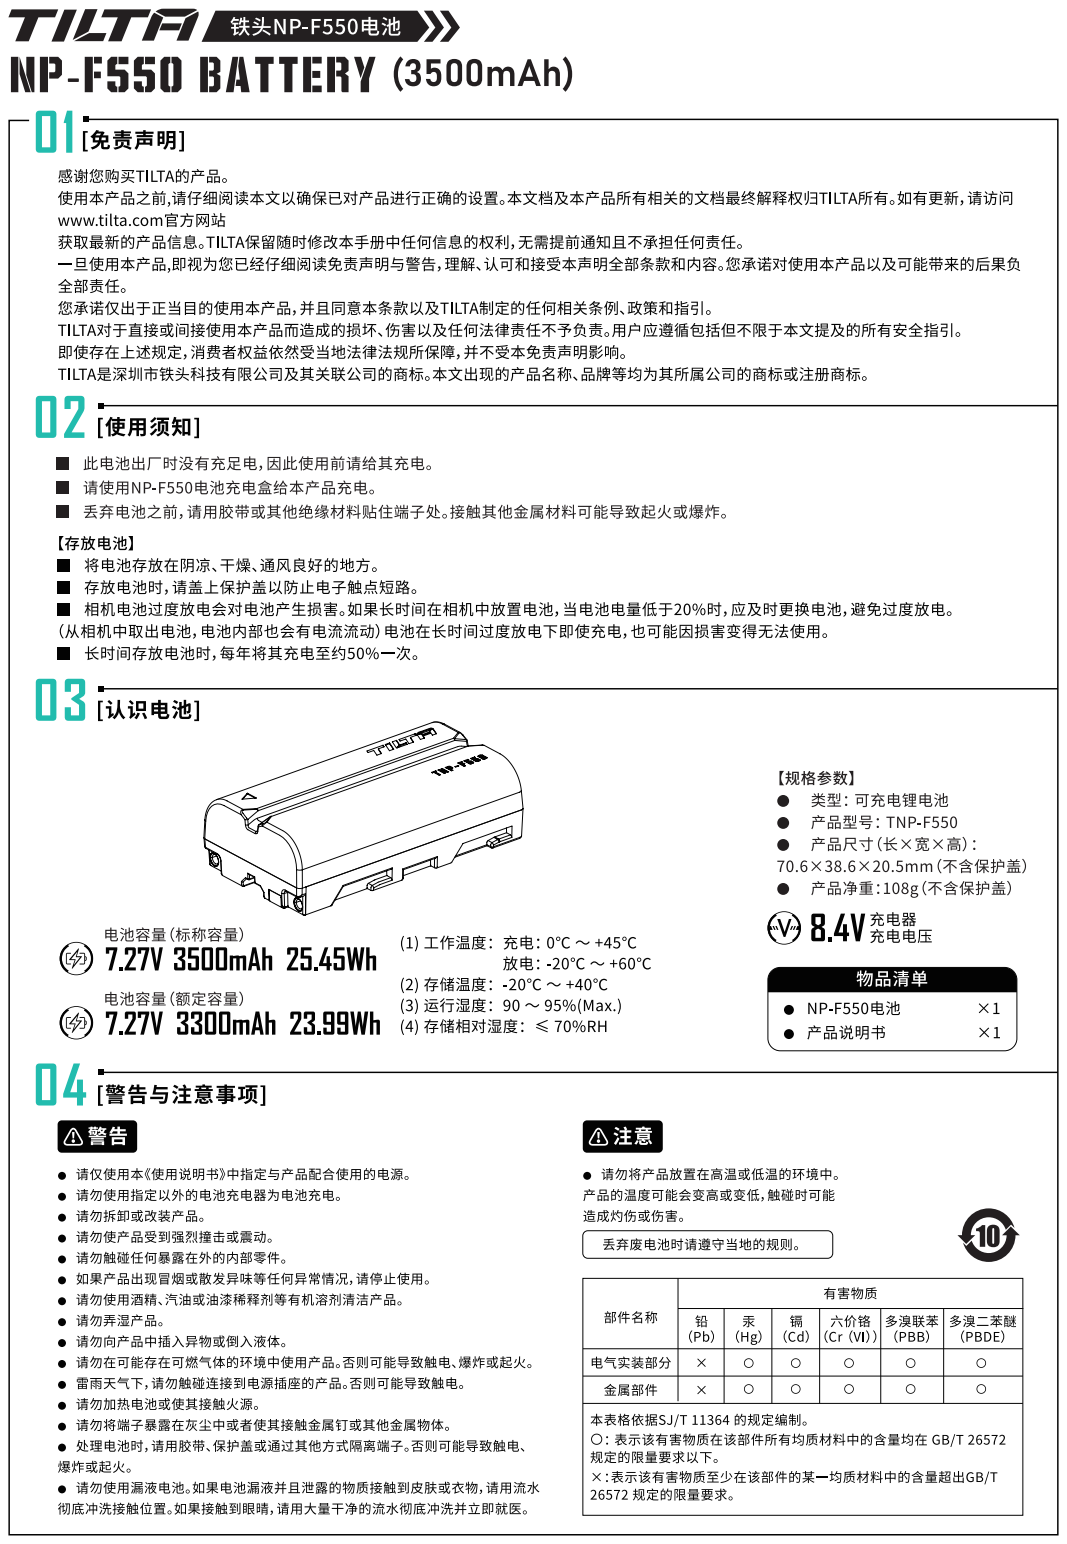
[picture p47: page 1]

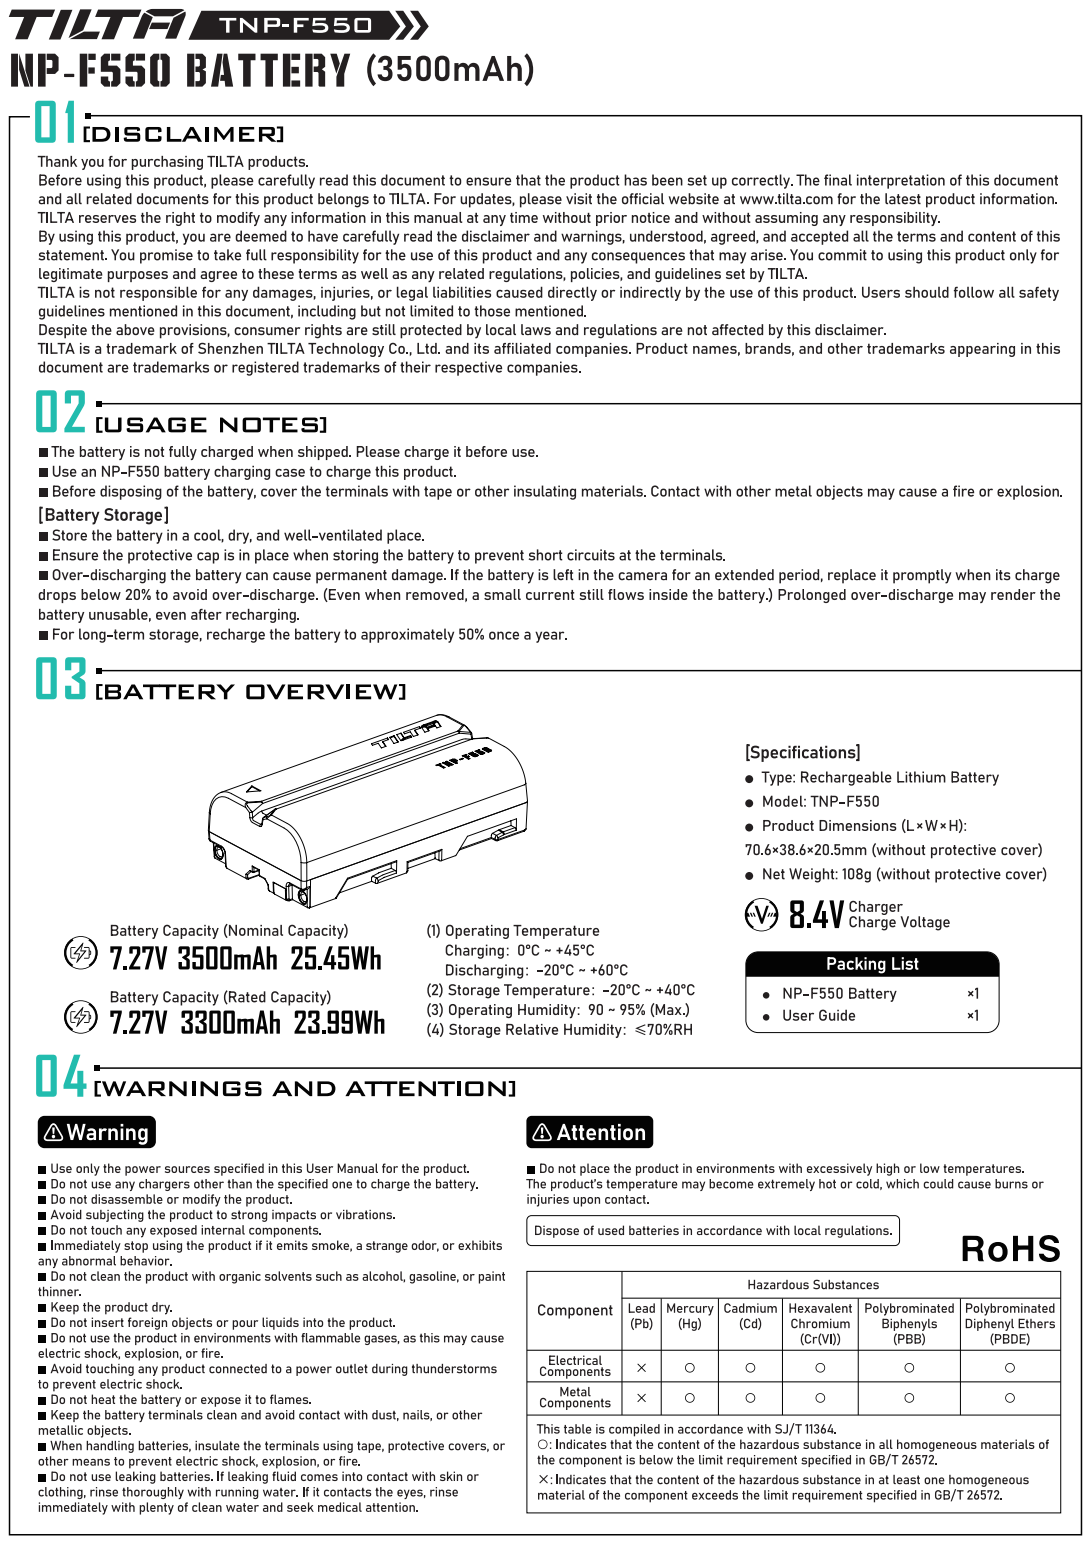
[picture p48: page 2]
