deanxizian/MicroDuck-Replica/Hardware/IMU-AMP2.0/KiCad/IMU-AMP2.0.kicad_pcb

## KiCad design Hardware/IMU-AMP2.0/KiCad/IMU-AMP2.0.kicad_pcb (2026-11-04)

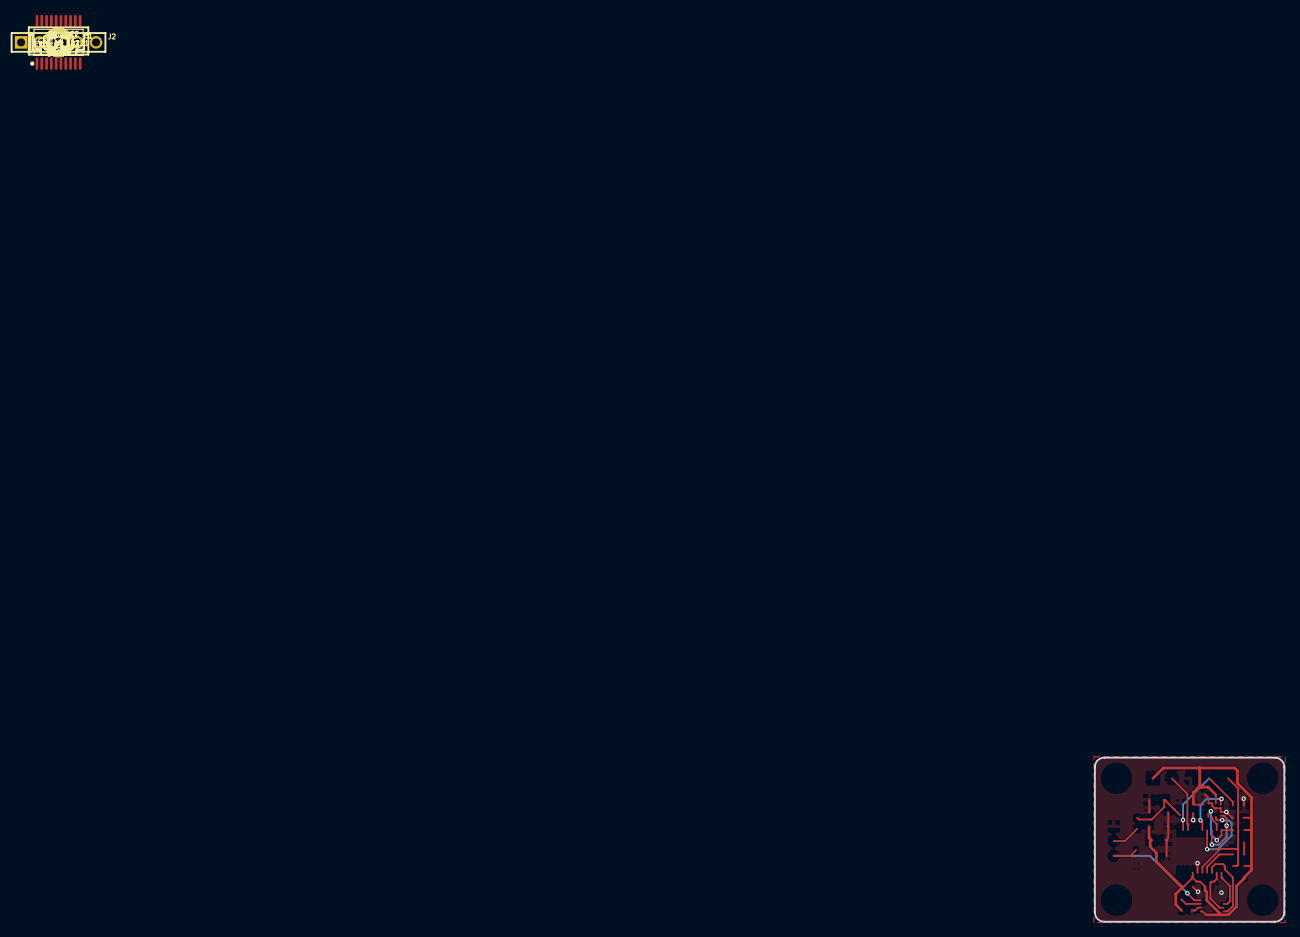
[picture p57: board IMU-AMP2.0.kicad_pcb from above]

Board: 2 copper layers, 25.7 x 22.2 mm, 25 parts (0 on the bottom side), 19 nets.

Parts:
C1, C3: 4.7uF; C0805
C2, C4, C5, C7, C8, C10: 100nF; C0603
C6, C9: 1uF; C0603
D1: PESD5V0S1BA; SOD-323_L1.7-W1.3-LS2.7-BI
D2: 19-217/GHC-YR1S2/3T; LED0603-RD
J1: A2007WV-3P; CONN-TH_A2007WV-3P
J2: PZ254V-11-05P; HDR-TH_5P-P2.54-V-M
R1: 0Ω; R0603
R2, R4, R5: 10kΩ; R0603
R3: 100kΩ; R0603
R6: 33Ω; R0603
R7: 1kΩ; R0603
U1: STM32G031F8P6; TSSOP-20_L6.5-W4.4-P0.65-LS6.4-BL
U2: LSM6DSV16XTR; LGA-14_L3.0-W2.5-P0.50-BR
U3: TLV70433DBVR; SOT-23-5_L3.0-W1.7-P0.95-LS2.8-BR
U4: SN74LVC2G125DCUR; VSON8_L2.0-W2.3-P0.50-LS3.1-BL

Connections:
3V3: C3.1, C4.1, C5.1, C6.1, C7.1, C8.1, C9.1, C10.1, J2.1, R2.1, R4.1, R5.1, U1.4, U2.5, U2.8, U3.3, U4.8
DEBUG_LED: R7.1, U1.7
DEBUG_LED_A: D2.2, R7.2
DXL_DATA: D1.1, J1.3, R6.2, U4.5
DXL_RX: U1.10, U4.3
DXL_TX: U1.9, U4.2
DXL_TX_EN: R5.2, U1.8, U4.1
DXL_TX_RAW: R6.1, U4.6
DXL_VDD: J1.2, R1.1
GND: C1.2, C2.2, C3.2, C4.2, C5.2, C6.2, C7.2, C8.2, C9.2, C10.2, D1.2, D2.1, J1.1, J2.3, R3.2, U1.5, U2.2, U2.3, U2.6, U2.7, U3.1, U3.4, U3.5, U4.4, U4.7
IMU_CS: R4.2, U1.11, U2.12
IMU_INT1: U1.15, U2.4
IMU_MISO: U1.13, U2.1
IMU_MOSI: U1.14, U2.14
IMU_SCK: U1.12, U2.13
LDO_IN: C1.1, C2.1, R1.2, U3.2
NRST: J2.5, R2.2, U1.6
SWCLK: J2.4, R3.1, U1.19
SWDIO: J2.2, U1.18
