deanxizian/MicroDuck-Replica/Hardware/Banana-NP-F550/KiCad/banana_pptc.kicad_pcb

## KiCad design Hardware/Banana-NP-F550/KiCad/banana_pptc.kicad_pcb (2026-11-04)

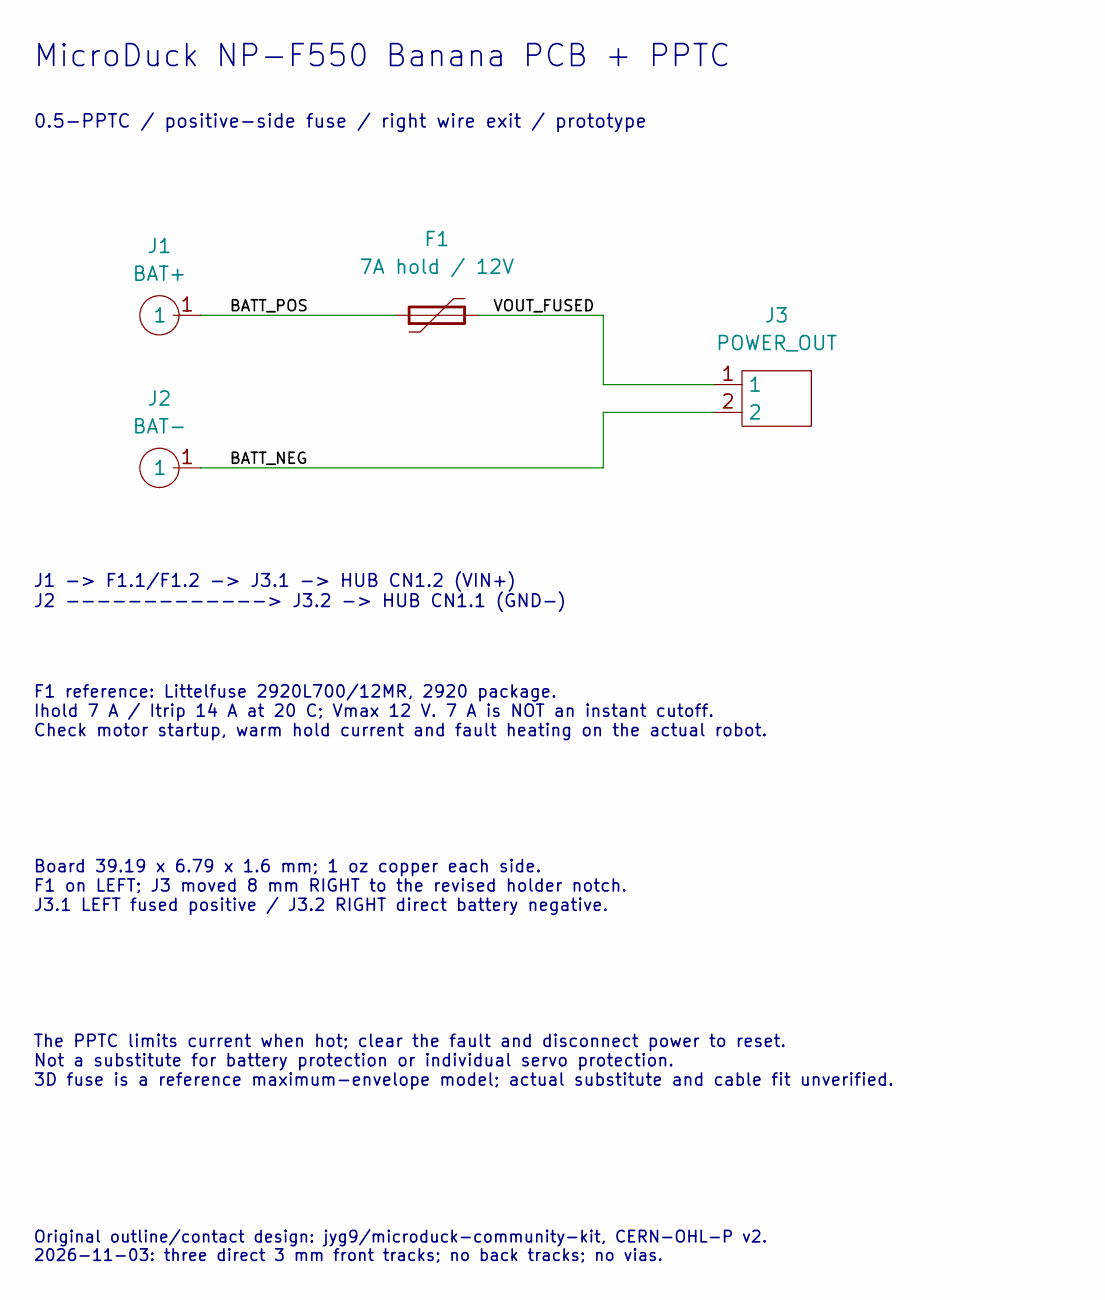
[picture p58: schematic banana_pptc.kicad_sch, MicroDuck Banana - positive-side PPTC prototype]

Parts:
F1: 7A hold / 12V; PPTC_Littelfuse_2920L
J1: BAT+; banana_pin
J2: BAT-; banana_pin
J3: POWER_OUT; pad-2(surf)

Connections:
/BATT_NEG: J2.1, J3.2
/BATT_POS: F1.1, J1.1
/VOUT_FUSED: F1.2, J3.1

Notes on the sheet:
MicroDuck NP-F550 Banana PCB + PPTC
0.5-PPTC / positive-side fuse / right wire exit / prototype
J1 -> F1.1/F1.2 -> J3.1 -> HUB CN1.2 (VIN+) J2 -------------> J3.2 -> HUB CN1.1 (GND-)
F1 reference: Littelfuse 2920L700/12MR, 2920 package. Ihold 7 A / Itrip 14 A at 20 C; Vmax 12 V. 7 A is NOT an instant cutoff. Check motor startup, warm hold current and fault heating on the actual robot.
Board 39.19 x 6.79 x 1.6 mm; 1 oz copper each side. F1 on LEFT; J3 moved 8 mm RIGHT to the revised holder notch. J3.1 LEFT fused positive / J3.2 RIGHT direct battery negative.
The PPTC limits current when hot; clear the fault and disconnect power to reset. Not a substitute for battery protection or individual servo protection. 3D fuse is a reference maximum-envelope model; actual substitute and cable fit unverified.
Original outline/contact design: jyg9/microduck-community-kit, CERN-OHL-P v2. 2026-11-03: three direct 3 mm front tracks; no back tracks; no vias.

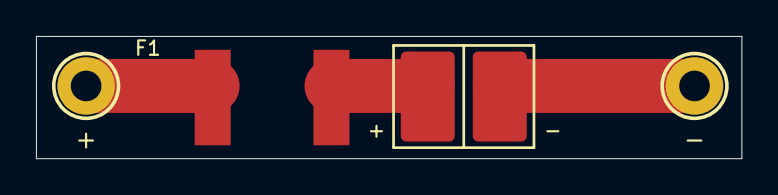
[picture p59: board banana_pptc.kicad_pcb from above]

Board: 2 copper layers, 39.2 x 6.8 mm, 4 parts (0 on the bottom side), 3 nets.
