deanxizian/MicroDuck-Replica/(commit log)

2026-11-04 整理 MicroDuck 复刻资料、BOM 与外设规格书 (#1)
    发布硬件与制造参考、29 件 STL/STEP、两套 Blender、统一 BOM 和已选外设规格资料。
    Code Review completed for 6b46b677c47b8006f360deaa94b52f10a15b3502 with no findings. Package hashes and local documentation links verified.
    [01_左脚底_TPU95A_黑色.step, 01_左脚底_TPU95A_黑色.stl, 02_右脚底_TPU95A_黑色.step, 02_右脚底_TPU95A_黑色.stl, 03_左脚掌_9000HE_白色.step, 03_左脚掌_9000HE_白色.stl, 04_右脚掌_9000HE_白色.step, 04_右脚掌_9000HE_白色.stl]
2026-11-04 整理硬件目录与采购清单，更新铁头电池装配 (#2)
    统一目录与文档，补齐 BOM 规格、数量、价格和购买链接，更新两套 Blender 的铁头电池参考模型及规格资料。
    [01_左脚底_TPU95A_黑色.step, 01_左脚底_TPU95A_黑色.stl, 02_右脚底_TPU95A_黑色.step, 02_右脚底_TPU95A_黑色.stl, 03_左脚掌_9000HE_白色.step, 03_左脚掌_9000HE_白色.stl, 04_右脚掌_9000HE_白色.step, 04_右脚掌_9000HE_白色.stl]
2026-11-05 更新相机保护结构、实物配色与采购清单 (#3)
    [23_脸板_IMX219孔距21x13.5_Zero柱下移1.5_JLCBlack_黑色.step, 23_脸板_IMX219孔距21x13.5_Zero柱下移1.5_JLCBlack_黑色.stl, 23_脸板_相机柱6.3_ToF横装等高_JLCBlack_黑色.step, 23_脸板_相机柱6.3_ToF横装等高_JLCBlack_黑色.stl, 27_眼睛_JLCBlack_黑色.step, 27_眼睛_JLCBlack_黑色.stl, 27_眼睛_厚6mm_JLCBlack_黑色.step, 27_眼睛_厚6mm_JLCBlack_黑色.stl]
